Arshiagosh/Vision-Obstacle-Avoidance-Robot/docs/report/Goshtasbi_BSc_Thesis_fa.pdf

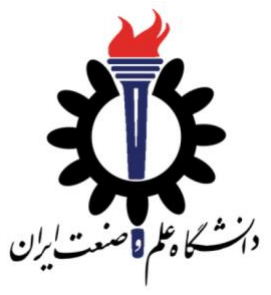
[picture p14: figure]

‌أ

دانشکده مهندسی برق

## طراح ی ، ساخت و کنترل ربات متحرک چرخدار در عبور از موانع با استفاده از دوربین و پردازش تصویر

پروژه پایانی کارشناسی در رشته مهندسی برق گرایش کنترل

ارشیا گشتاسبی حسن آبادی

استاد راهنما: دکتر محمد فرخی

تابستان 1403

ب‌

## تاییدیه هیئتداوران جلسه دفاع از پایاننامه /رساله

نام دانشکده: مهندسی برق

نام دانشجو: ارشیا گشتاسبی حسن آبادی

عنوان پایاننامه یا رساله: طراحی، ساخت و کنترل ربات متحرک چرخ دار در عبور از موانع با استفاده از دوربین و پردازش تصویر

تاریخ دفاع:

رشته: مهندسی برق

گرایش: کنترل

دانشگاه یا موسسه امضا | دانشگاهی | ردیف سمت نام و نام خانوادگی مرتبه
| | 1 استاد راهنما محمد فرخی استاد علم و صنعت ایران
| | 2 استاد مدعو داخلی جواد پشتان استاد علم و صنعت ایران

ت‌

### تایی دیه صحت و اصالت نتایج

باسمه تعالی

اینجانب ارشییا گشیتاسیبی حسین آبادی به شیماره دانشیجویی 98412391 دانشیجوی رشیته مهندسیی برق گرایش کنترل مقطع تحصییلی کارشیناسیی تایید می نمایم که کلیه ی نتایج این پایاننامه حاصیک کار اینجانب و بدون هرگونه دخک و تصرف است و موارد نسخهبرداری شده از آثار دیگران را با ذکر کامک مشخصات منبع ذکر کردهام. درصیورت اثبات خفف مندرجات فوق، به تشیخید دانشیگاه مطابا با بیوابم و مقررات حاکم ونانون حمایت از حقوق مؤلفان و مصیینفان و نانون ترجمه و تکریر کتب و نشییریات و آثار صییوتی، بییوابم و مقررات آموزشییی، پژوهشیی و انضیباطی ... با اینجانب رفتار خواهد شید و حا هرگونه اعتراد در خصیوح احقاق حقوق مکتسیب و تشییخید و تعیین تخلف و مجازات را از خویش سییلب مینمایم. در بییمن، مسییؤولیت هرگونه پاسییخگویی به اشییخاح اعم از حقیقی و حقونی و مراجع ذیصییف) واعم از اداری و نضییایی به عهدهی اینجانب خواهد بود و دانشگاه هیچگونه مسؤولیتی در این خصوح نخواهد داشت.

نام و نام خانوادگی: ارشیا گشتاسبی حسن آبادی

امضا و تاریخ:

ث‌

### مجوز بهرهبرداری از پایاننامه

بهره برداری از این پایاننامه در چهارچوب مقررات کتابخانه و با توجه به محدودیتی که توسیم اسیتاد راهنما به شر) زیر تعیین می شود، بفمانع است:

بهرهبرداری از این پایاننامه برای همگان بفمانع است. بهرهبرداری از این پایاننامه با اخذ مجوز از استاد راهنما، بفمانع است.
بهرهبرداری از این پایاننامه تا تاریخ | ممنوع است.

نام استاد یا اساتید راهنما: دکتر محمد فرخی

تاریخ:

امضا:

‌ج

## تقدیم به

## خانواده عزیزتر جانم،

برای عشق، حمایت، همراهی و دلگرمیهای بیپایان.

‌ح

### تشکر و تقدیر

با کمال افتخار و سیسا ، از اسیتاد گرانقدرم جناب آنای دکتر فرخی تشیکر میکنم. ایشیان نه تنها با دانش گسیترده و راهنماییهای ارزندهشیان در تمام مراحک این پروژه همراه من بودند، بلکه من را با نگاهی عمیاتر به علم و پژوهش آشیینا کردند. از ایشییان در های بسیییاری درباره تفکر نقادانه، حک مسییاوک، و پشییتکار در پژوهش آموختم که در طول این مسییییر و فراتر از آن، برای من ارزشیییمند خواهند بود. بیتردید، این پروژه بدون راهنماییها و حمایتهای بیونفهی ایشان به این مرحله نمیرسید.

‌خ

### چکیده

رباتهای متحرک یکی از پرکاربردترین سیستمهای کنترلی میباشند . در این پایان نامه، ربات دوچرخ دیفرانسیلی طراحی و ساخته شده که نادر است مسیر مناسب را طی کرده و از موانع پیشرو اجتناب کند. این ربات شامک دو چرخ مستقک متصک به موتور DC و یک چرخ هرزگرد است که با تغییر سرعت چرخ ها، سه درجه آزادی ومختصاتx، y و زاویه برای مانور را فراهم می سازد. هدف اصلی ربات، حرکت به سمت مقصد تعیین شده و اجتناب از موانع موجود در مسیر است. برای دستیابی به این هدف، دو الیه سیستم کنترلی به کار رفته است. در الیه پایین، انکودرها برای مونعیت یابی دنیا و کنترل سرعت ربات با استفاده از کنترل کننده PID بهکارگرفته شده اند. در الیه باالتر، حسگرهای فراصوت و دوربین ومتصک به یک سروو موتور به منظور تشخید موانع و هدایت هوشمند ربات برای جلوگیری از برخورد و انتخاب مسیر مناسب استفاده شده است. نتایج آزمایشهای عملی نشان داده است که ربات توانسته است با دنت باال مسیرهای مشخد شده را طی کرده و به طور همزمان از موانع اجتناب کند. این دستاورد نشان دهنده عملکرد مناسب سیستم های کنترلی و حسگرهای به کار رفته در این پروژه است.

کلیدواژه: ربات دوچرخ دیفرانسیلی، مسیریابی ربات، مونعیتیابی، اجتناب از موانع، انک ودر، کنترل کننده PID، پردازش تصویر، دوربین

‌د

فهرست

فصل :1 مقدمه 1 |
1-1 تاریخچه 2 |
2-1 مزایا و معایب 3 |
3-1 کاربردها 3 |
4-1 دستهبندی رباتهای متحرک چرخدار 4 |
5-1 مدلسازی 4 |
6-1 روش های اجتناب از مانع و مسیریابی 5 |
7-1 پردازش تصویر 6 |
8-1 شمای کلی از الیههای کنترلی 7 |
9-1 پیکربندی پایاننامه 8 |
1-2 مقدمه 10 |
2-2 بدنه 10 |
3-2 چرخها 11 |
4-2 موتورها 11 |
5-2 باتری 12 |
6-2 انکودر و مدار انکودر 13 |
7-2 کارانداز موتور 14 |
9-2 حسگرهای فراصوت 17 |
10-2 برد رزبریپای 18 |
11-2 ارتباط سریال 19 |
12-2 دوربین 20 |
13-2 سروو موتور 21 |

‌ذ

1-3 مقدمه 24 |
2-3 کنترل الیه پایین24 |
-2-3 1 کنترل موتور 25 |
-2-3 3 کنترل جهت نهایی 28 |
3-3 کنترل الیه باال29 |
-3-3 1 تونف در مقابک مانع و فرآیند اجتناب از مانع 29 |
-3-3 2 فاصلهسنجی با استفاده از دوربین 30 |
-3-3 3 بهترین زاویه خروج 32 |
1-4 مقدمه 35 |
2-4 طی کردن مسیر بدون مانع و رفتن به هدف 35 |
-2-4 1 حالت اول 35 |
-2-4 2 حالت دوم 38 |
-2-4 3 حالت سوم 41 |
3-4 طی کردن مسیر با مانع 44 |
-3-4 1 دور زدن مانعها 44 |
-3-4 2 حرکت از بین مانعها 48 |
4-4 جمعبندی و پیشنهادات 52 |
مراجع 53 |

‌ر

فهرست شکلها
شکک 1-1 مدل ریابیاتی ربات چرخدار دیفرانسیلی 4 |
شکک 2-1 شمای کلی از الیه های کنترلی 7 |
شکک 1-2 نمای جلو ربات ساختهشده10 |
شکک 2-2 نمای باال ربات ساختهشده11 |
شکک 3-2 موتور DC انکودردار12 |
13 | M25N-2R-14 | انکودر | 4-2 شکک
شکک 5-2 پایههای انکودر 14 |
شکک 6-2 ماژول N298L 14 |
شکک 7-2 نمای درونی کارانداز N298L15 |
شکک 9-2 حسگر فراصوت 04SR-HC17 |
شکک 10-2 برد رزبریپای 4 مدل B 19 |
20 | USB-STC-ISP مبدل 11-2 شکک
شکک 12-2 دوربین رزبریپای مدل 1.3v20 |
شکک 13-2 سروو موتور 90SG21 |
شکک 1-3 بلوک دیاگرام الیه پایین 24 |
شکک 2-3 نمایش انعکا دنیای سهبعدی برروی صفحع تصویر دوبعدی 31 |
شکک 3-4 نمودار تغییرات y برحسب زمان در مسیر بدون مانع و رفتن به هدف اول 37 |
شکک 4-4 نمودار سیگنالهای کنترلی اعمال شده به موتور چپ ربات در مسیر بدون مانع و رفتن به
هدف اول 37 |
شکک 5-4 نمودار سیگنالهای کنترلی اعمال شده به موتور راست ربات در مسیر بدون مانع و رفتن به
هدف اول 38 |
شکک 6-4 نمودار مسیر طی شده توسم ربات در مسیر بدون مانع و رفتن به هدف دوم 39 |

‌ز

شکک 7-4 نمودار تغییرات x برحسب زمان در مسیر بدون مانع و رفتن به هدف دوم 39 |
شکک 8-4 نمودار تغییرات y برحسب زمان در مسیر بدون مانع و رفتن به هدف دوم 40 |
شکک 9-4 نمودار سیگنالهای کنترلی اعمال شده به موتور چپ ربات در مسیر بدون مانع و رفتن به
هدف دوم 40 |
شکک 10-4 نمودار سیگنالهای کنترلی اعمال شده به موتور راست ربات در مسیر بدون مانع و رفتن به
هدف دوم 41 |
شکک 11-4 نمودار مسیر طی شده توسم ربات در مسیر بدون مانع و رفتن به هدف سوم 42 |
شکک 12-4 نمودار تغییرات x برحسب زمان در مسیر بدون مانع و رفتن به هدف سوم 42 |
شکک 13-4 نمودار تغییرات y برحسب زمان در مسیر بدون مانع و رفتن به هدف سوم 43 |
شکک 14-4 نمودار سیگنالهای کنترلی اعمال شده به موتور چپ ربات در مسیر بدون مانع و رفتن به
هدف سوم 43 |
شکک 15-4 نمودار سیگنالهای کنترلی اعمال شده به موتور راست ربات در مسیر بدون مانع و رفتن به
هدف سوم 44 |
شکک 16-4 نمودار مسیر طی شده توسم ربات در مسیر با مانع و دور زدن مانع 45 |
شکک 17-4 نمودار تغییرات x برحسب زمان در مسیر با مانع و دور زدن مانع 45 |
شکک 18-4 نمودار تغییرات y برحسب زمان در مسیر با مانع و دور زدن مانع | 46
شکک 19-4 نمودار سیگنالهای کنترلی اعمال شده به موتور چپ ربات در مسیر با مانع و دور زدن موانع
46 |
شکک 20-4 نمودار سیگنالهای کنترلی اعمال شده به موتور راست ربات در مسیر با مانع و دور زدن
موانع 47 |
شکک 21-4 حرکت ربات در مسیر با مانع 47 |
شکک 22-4 نمودار مسیر طی شده توسم ربات در مسیر با مانع و حرکت از بین موانع 48 |
شکک 23-4 نمودار تغییرات x برحسب زمان در مسیر با مانع و حرکت از بین موانع 48 |
شکک 24-4 نمودار تغییرات y برحسب زمان در مسیر با مانع و حرکت از بین موانع 49 |
شکک 25-4 نمودار سیگنالهای کنترلی اعمال شده به موتور چپ ربات در مسیر با مانع و حرکت از بین
موانع 49 |

س‌

شکک 26-4 نمودار سیگنالهای کنترلی اعمال شده به موتور راست ربات در مسیر با مانع و حرکت از بین
موانع 50 |
شکک 27-4 یک نمونه از تصاویر گرفتهشده از مانع توسم دوربین 51 |
شکک 28-4 تصویر گرفتهشده در شکک 27-4 پس از اعمال الگوریتم پردازش تصویر 51 |

ش‌

فهرست جدولها

جدول -2 1 پارامترهای موتور DC12 |
جدول -2 2 مشخصات Uno Arduino 17 |
جدول -2 3 مشخصات حسگر آلترسونیک 04SR-HC18 |
جدول -2 4 مشخصات برد رزبریپای 4 مدل B 19 |
جدول -2 5 مشخصات دوربین رزبریپای مدل 1.3v 21 |
جدول -2 6 مشخصات سروو موتور 90SG 22 |

## فصل :1 مقدمه

### 1-1 تاریخچه

رباتها، س یستمهای الکترومکانیکی پیشرفته ای هستند که از طریا برنامه ریزی کامسی وتری می توانند وظایف پیچیده و دنیا را به طور خودکار انجام دهند. این دستگاهها نابلیت جایگزینی نیروی انسانی در بسیاری از صنایع و کاربردها را دارند و به دلیک دنت، سرعت و نابلی ت اجرای مکرر وظایف بدون خطا، به ویژه در صنایع تولید ی مورد توجه نرار گرفته اند. یکی از اولین نمونه های کاربرد رباتیک در صنعت، بازوهای رباتیکی است که در انجام عملیات تکراری مانند جوشکاری، مونتاژ و بسته بند ی با دنت و سرعت بی نظیر به کار گرفته می شوند . اما این نوع ربات ها با وجود دنت و کارایی باال، در یک مح یم ثابت محدود هستند و امکان حرکت در فضا را ندارند، که این موبوع یکی از نقاط بعف آن ها محسوب م یشود.

در مقابک، ربات های متحرک دارای توانایی حرکت در محیم های پویا و نامشخد هستند که باعث
می شود انعطافپذ یری بیشتر ی نسبت به ربات های ثابت داشته باشند. این نوع ربات ها می توانند در فضاهای مختلف حرکت کرده، موانع را شناسایی کرده و با توجه به شرایم موجود، تصمیم گیر یهای هوشمندانه ای برای پیمایش مسیر اتخاذ کنند. چالشهای کلید ی در طراحی و استفاده از رباتهای متحرک شامک مسیریابی، مونعیت یابی دنیا و کنترل حرکات آن ها است. یک ربات متحرک باید به طور مستمر مونعیت خود را در فضا تعیین کند و با تحلیک اطفعات محی طی مانند موانع و مسیرها، بهترین و بهینه ترین راه را برای رس یدن به هدف انتخاب نماید .

رباتهای متحرک از دهه 1960 به این سو پیشرفت های نابک توجهی داشته اند. در سال ،1969 ربات Shakey توسم International SRI معرفی شد که اولی ن رباتی بود که نادر به برنامه ریزی، درک محیم و تصمیم گیری مستقک بود. این ربات از حسگرهایی مانند دورب ین و لی زر برا ی تشخید موانع و مسیریابی استفاده می کرد. در سال ،1977 دانشگاه توکیو ربات زیرآبی Pioneer را ساخت که می توانست به طور مستقک در اعماق انیانو ها حرکت کند. در دهه ،1990 ناسا با ارسال ربات Sojourner به مریخ، اولین کاوشگر رباتی ک مستقک را به کار گرفت که از حسگرها و دوربین ها برای شناسایی محیم استفاده می کرد. در سال ،2000 شرکت هوندا ربات انساننمای ASIMO را معرفی کرد که توانایی راه رفتن، دویدن و تعامک با انسان ها را داشت، گامی مهم در توسعه ربات های متحرک انسان نما. در دهه ،2010 ربات های پیشرفته تری مانند Quadrotor توسم دانشگاه زوریخ ساخته شد که به طور مستقک در فضاهای پیچ یده پرواز می کرد و حرکات مانورپذ یر انجام می داد. همچنین Spot از Dynamics Boston، با توانایی حرکت در محیم های ناهموار و پیچیده، نمایانگر نسک جد ید ی از رباتهای چهارپا بود.

تاریخچه ربات یک با سرعت زیادی در حال پیشرفت است و هر ساله شاهد معرف ی ربات های جد یدتر و هوشمندتری هستیم که نابلی تهای آن ها برای انجام وظای ف پیچیده تر و حرکت در محیم های پویا افزایش می یابد .

### 2-1 مزایا و معایب

باوجود مزایای رباتهای متحرک چرخدار، چالشهای نیز وجود دارند که در ادامه به مهمترین مزایا و معایب این ربات ها اشاره شده است.

مزایا:

- انعطافپذیری در فضاهای تنگ و کوچک
- سرعت باالی جابهجایی
- تعامک با محیم
- نابلیت استفاده در محیم های پرخطر و کاهش هزینهها
- سهولت ساخت و توسعه

معایب:

- محدودیت در حمک بار
- حساسیت به نوع سطح
- عملکرد نامطلوب در محیم هایی با شرایم سخت ومرف زمین ناهموار

### 3-1 کاربردها

ربیاتهیای متحرک چرخدار در حوزههیای مختلف کیاربرد دارنید. در انبیارداری و لجسیییتییک، این ربیاتهیا
برای جابهجایی کاالها بین نفسیهها در شرکتهایی مانند دیجیکاال و آمازون استفاده میشوند. در محیم های صیینعتی، این رباتها برای حمک نطعات به کار میروند. در هتکها و بیمارسییتانها، رباتها میتوانند دارو و مواد غیذایی را منتقیک کننید. همچنین در محیم هیای خطرنیاک مریک عملییاتهیای نجیات ییا منیاطا آلوده، بیه جای انسان به اکتشاف و جمعآوری اطفعات میپردازند .

### 4-1 دستهبندی رباتهای متحرک چرخدار

رباتهای متحرک چرخ دار به دو دسته کلی هولونومیک و غیرهولونومیک تقسیم می شوند. رباتهای هولونومیک دارای آزادی کامک در حرکت هستند و میتوانند به هر جهتی حرکت کنند. اما رباتهای غیرهولونومیک محدودیت های حرکتی دارند و معموالً فقم در جهتهای خاصی حرکت می کنند، مانند رباتهای دیفرانسیلی. در سیستم دیفرانسیلی، حرکت ربات به تفاوت سرعت چرخ های آن وابسته است، که این دسته از ربات ها برای حرکت در مسیرهای پیچیده و محیم های ناشناخته کاربرد دارند .

ربات متحرک مورد بررسی در این پایان نامه، ربات متحرک چرخ دار دیفرانسیلی غیرهولونومیکی با دو
چرخ کنترلپذیر و یک چرخ هرزگرد میباشد.

### 5-1 مدلسازی

از جهت شیناخت سییسیتم و در نتیجه طراحی کنترلکننده مناسیب، الزم اسیت که مدل ریابییاتی مبنی
بر معادالت سیینماتیکی مورد بررسیی نرار گیرند که معادالت و شیکک این ربات چرخدار به ترتیب در شیکک -1 1 و معادالت و1-1 ذکر شدهاند:

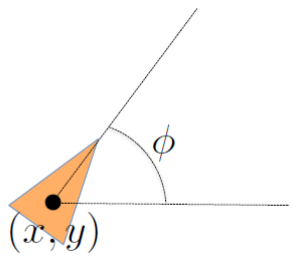
[picture p15: figure]

شکک :1-1 مدل ریابیاتی ربات چرخدار دیفرانسیلی

و1-1 ()ocv = ̇
ẏ = vsin(φ)
φ̇ = ω
الزم به ذکر اسیت که در این مدل، و به ترتیب سیرعت زاویهای خطی ربات میباشیند. با توجه به اینکه در الیه کنترلی پایین، که در آردوینو پیادهسیازی شیده اسیت، سیرعت دو موتور دو سیمت ربات کنترل

⁵

میشیییونید، تبیدییک این روابم بیه سیییرعیت خطی هر چرخ الزم اسیییت کیه این روابم در معیادالت و1-2 نیابیک مشاهدهاند:

و2-1 = ν

2v+ωL
2R
νL =

2v−ωL
2R
به ترتیب، سیرخت خطی چرخ | که در آنها ν و
های راسیت و چپ، و L و R به ترتیب عرد ربات و شیعاع
چرخهای ربات میباشند.

در مجموع، از رابطیه و1-1 برای کنترل مونعییت ربیات در جهیان خیارج و از رابطیه و2-1 برای کنترل سرعت چرخش هر چرخ استفاده میشود.

### 6-1 روش های اجتناب از مانع و مسیریابی

رباتهای متحرک چرخ دار به دلیک توانایی در حرکت در محیم های مختلف و مانورده ی در مسیرهای پیچیده، یک ی از مهم ترین موبوعات در علم رباتیک و مهندسی کنترل به شمار می روند . الگوریتم های مسیریابی و اجتناب از موانع برا ی هدای ت این ربات ها نقشی کل ید ی دارند. در ادامه چند ین الگوریتم مسیر یابی که به کنترل و هدایت رباتهای چرخ دار کمک می کنند، معرفی و بررس ی شده اند:

.1 الگوریتم تعقیب دیوار

1

این الگوریتم یک ی از ساده ترین و ابتدایی ترین روش های مسیریابی برای رباتهای متحرک است. ربات
با دنبالکردن دیوار یا موانع موجود، مسیر خود را ادامه م یدهد و با تنظی م حرکت خود بر اسا مونعیت موانع، از آن ها عبور می کند . ای ن روش بیشتر در محیم های محدود و ساختارهای مسدودشده استفاده می شود. با این وجود، این الگوریتم ی ک محدودیت دارد: ربات به تنهایی نادر به حرکت در فضای باز یا دور از موانع نیست [1].

.2 الگوریتم درخت جستجوی تصادفی سریع

2

الگوریتم RRT یکی از روش های پیشرفته برا ی مسیریابی در محیم های ناشناخته و پی چیده است. این الگوریتم با تولید تصادف ی نقاط در محیم و ایجاد یک درخت مسیر به ربات کمک م یکند تا سریعاً نقاط مختلف محیم را کشف کرده و بهینه ترین مسیر را بیابد . در محیم های بزرگ و ناشناخته، این روش به دلیک تولید سری ع مسیرها ی تصادف ی و سسس بهینه سازی آن ها، عملکرد بسیار خوب ی دارد [2].

1
Follow the wall
2 Rapidly Exploring Random Tree (RRT)

.3 الگوریتم ستاره

3

الگوریتم Star A یکی از محبوب ترین و شناخته شدهتری ن روش های مسیریابی است که بر مبنای جستجوی گراف استوار است. این الگوریتم با استفاده از روش های جستجوی هوشمندانه، کوتاه ترین مسیر را از مبدا به مقصد با در نظر گرفتن موانع موجود پیدا می کند . این الگوریتم به ویژه برا ی مسیریابی رباتهایی که به دنبال یافتن مسیرهای بهینه در محیم های مشخد هستند، بسیار مناسب است [3].

.4 الگوریتم مکان یابی و نقشه برداری همزمان بصری

4

یکی از روش های پیشرفته در رباتیک، استفاده از الگوریتم SLAM است که به ربات امکان می دهد
به طور همزمان محیم اطراف خود را نقشه برداری کرده و مونعیت خود را در آن مح یم تعیین کند. Visual SLAM از تصاویر دورب ین و لیزر برای به روزرسانی نقشه و تعیین مونعیت استفاده می کند . این الگوریتم به ربات اجازه میدهد تا بدون ن یاز به حسگرهای دیگر، تنها با استفاده از اطفعات بصر ی محیم، به طور دنیا مسیر خود را ط ی کند [4].

.5 الگوریتم میدان پتانسیک

5

در این روش، محیم اطراف ربات به عنوان یک میدان نیرو در نظر گرفته می شود؛ به طوری که موانع مانند نیروهای دافعه و هدف به عنوان نیروهای جاذبه عمک می کنند . ربات با هدایت خود در این میدان، به سمت هدف حرکت می کند و همزمان از برخورد با موانع جلوگیری می کند . این روش در عین سادگی، یکی از موثرتر ین روش ها برای اجتناب از موانع است، اما در شرای طی که موانع بسیار نزدیک به هم باشند ممکن است باعث گیر افتادن ربات شود [5].

این الگوریتم ها و روش های مسیریابی می توانند به عنوان ابزارهای مهمی در هدایت رباتهای متحرک
چرخ دار استفاده شوند. ترکی ب آن ها با پردازش تصویر به ویژه در محیم های ناشناخته و پی چیده می تواند به بهبود عملکرد و دنت مسیریاب ی کمک کند.

### 7-1 پردازش تصویر

پردازش تصویر یکی از روش های مؤثر در تشخید فاصله تا اجسام برای رباتهای متحرک است. دوربین مونو به عنوان یک حسگر بصری استفاده می شود که از طریا تبدیک سیگنال های نوری به داده های

3 A Star (A*)
4 Visual SLAM (Simultaneous Localization and Mapping)‌‌ 5 Potential Field

دیجیتال، امکان تحلیک عما را فراهم می کند. این داده ها با استفاده از الگوریتم های بینایی کامسیوتری و تکنیک های پردازش تصویر تجزیه و تحلیک می شوند و به ربات کمک می کنند تا فاصله تا موانع را تخمین زده و از آن ها جلوگیری کند. هدف این بخش، محاسبه دنیا فاصله با استفاده از اطفعات پیکسلی تصویر است. با این حال، در شرایطی که دنت بیشتری مورد نیاز باشد، از دوربین استریو نیز می توان بهره برد که به کمک تصاویر همزمان از دو زاویه، امکان محاسبه عما به شکک دنیا تری فراهم می شود. این روش ها نه تنها در جلوگیری از برخورد با موانع کاربرد دارند، بلکه به بهبود هدایت ربات در محیم های پیچیده نیز کمک می کنند . هر تصویر به عنوان سیگنالی شامک مقادیر پیکسلی است که پس از نمونه برداری به سیگنال دیجیتال تبدیک می شود . بینایی کامسیوتری راهی برای شبیه سازی توانایی یادگیری و کسب اطفعات از ورودی های بصری است که رایجترین آن، استفاده از دوربین و پردازش تصاویر برای تحلیک و تصمیم گیری در مورد محیم است.

### 8-1 شمای کلی از الیههای کنترلی

با توجه به طراحی ربات بهصورت الیه الیه و نابلیت جایگزینی آنها، یک شمای اولیه و کلی از اجزای ربات و ارتباط آنها باهم در شکک2-1 اراوه شدهاست.

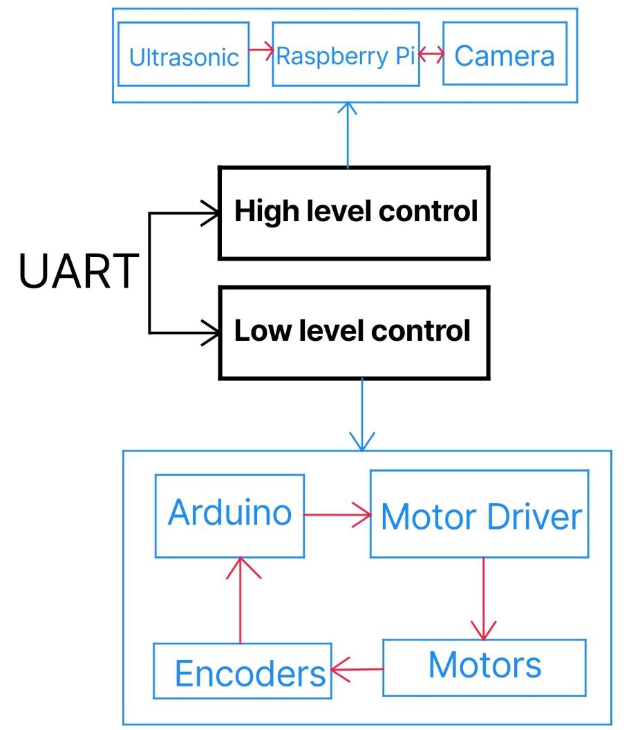
[picture p16: figure]

شکک :2-1 شمای کلی از الیههای کنترلی

### 9-1 پیکربندی پایاننامه

در ادامه، این پایاننامه در نالب فصکهای زیر دنبال می شود: فصک دوم به معرفی و توبیح ساختار مکانیکی و الکترونیکی ربات میپردازد. در این فصک به بررسی نطعات، میکروکنترل کنندهها و بردهای استفاده شده پرداخته میشود. سسس در فصک سوم الگوریتمهای کنترل در دو الیه پایین و باال و الگوریتمهای پردازش -تصویر اراوه میگردند. در فصک چهارم نیز نتایج حاصک از آزمایشهای عملی صورت گرفته بر ربات در حالتهای مختلف گزارش میشوند و در پایان این فصک، جمعبندی و پیشنهادات اراوه خواهد گردید.

## فصل :2 ساختار مکانیکی و الکترونیکی ربات

### 1-2 مقدمه

ربات طراحیشده از نوع رباتهای متحرک چرخ دار است و دارای بدنهای مستطیک شکک و دو چرخ متصک به دو موتور DC انکودردار میباشد. چرخها دارای یک درجه آزادی بوده و ربات از نوع غیرهولونومیک است. در ارتباط با ساختار کلی ربات، با توجه به طراحی الیهای، از دو برد آردوینو و رزبریپای به صورت همزمان استفاده میشود. در الیه پایین کنترلی، انکودرها، کارانداز موتورها، مدار تغذیه و برد آردوینو نرار دارند. در الیه باال نیز، برد رزبریپای، دوربین، حسگر فراصوت و سروو موتور برای چرخاندن دوربین نرار داده شدهاند.

در این فصک به بررسی ساختمان و ادوات مکانیکی و همچنین مدارهای الکترونیکی گوناگون به کاررفته
در این ربات پرداخته میشود.

### 2-2 بدنه

بدنهی ربات از دو شاسی مستطیک به طول 16 سانتیمتر و عرد 14سانتیمتر تشکیک شده است که بهوسیله چهار پایه به هم متصک شدهاند. یک بردبُرددر طبقه پایین نرار داده شده است و آردوینو و اتصاالت آن در این طبقه انجام شده است. در طبقه باال، برد رزبری پای، کارانداز موتورها، باتری، سروو موتور و دوربین متصک به آن و حسگرهای فراصوت نرار داده شده است. موتورها به کناره شاسی پایینی متصک میشوند. جنس شاسیها از پلکسی به بخامت 3 میلیمتر میباشد که باعث سبکی ربات میشوند. در شککهای -2 1 و -2 2 ربات ساخته شده مشاهده میشود.

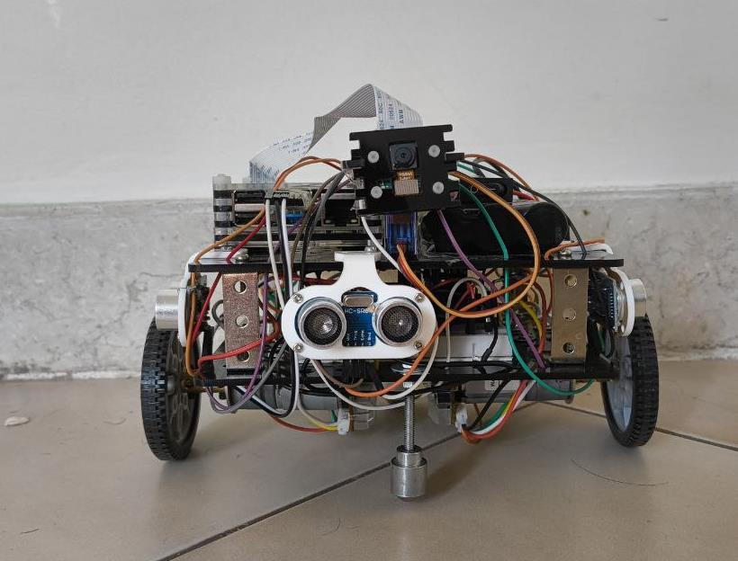
[picture p17: figure]

شکک :1-2 نمای جلو ربات ساختهشده

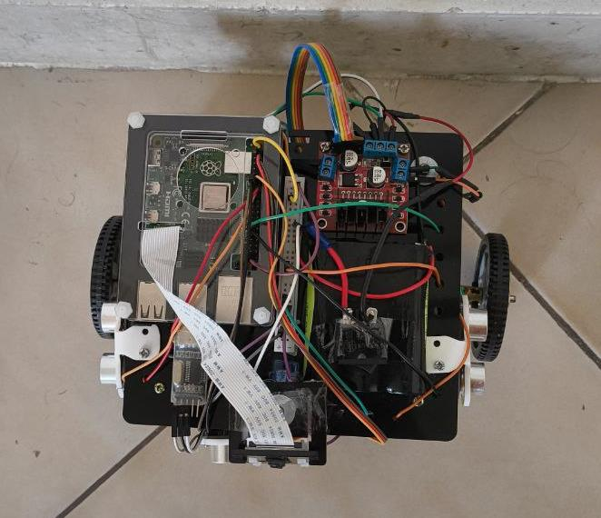
[picture p18: figure]

شکک :2-2 نمای باال ربات ساختهشده

### 3-2 چرخها

ربات دارای دو چرخ پفستیکی به شعاع 3 سانتیمتر میباشد که مرکز چرخها به شفت موتورها متصک شدهاند و موتور از طریا براکتها به بدنه ربات اتصال دارد. چرخها باید بهگونهای باشند که هنگام حرکت دچار لغزش نشوند و تمام محورهای فرمان چرخ عمود بر زمین باشند. چرخهای این ربات موازی هم نرار گرفتهاند که در این حالت به آنها Dicycle گفته میشود. ربات دارای یک چرخ هرزگرد نیز میباشد.

### 4-2 موتورها

در ساخت این ربات از دو موتور DC انکودردار استفاده شدهاست که این موتورها به شفت چرخها متصک میشوند. موتور بهکار بردهشده دارای 1.5 ولت باند مرده میباشد. در ولتاژهای بسیار پایین، گشتاور کمتر از حدی است که بتواند بر نیروهای بازدارنده غلبه کرده و موتور را به حرکت درآورد. به ناحیهای که ولتاژ اعمالی تاثیری بر حرکت موتور ندارد باند مرده گفته میشود. با توجه به وجود این مسئله، برای کنترل موتورها، این مقدار باید همواره در نظر گرفته شود و به سیگنال کنترلی اعمال گردد. از سویی الزم به ذکر است که برای کنترل این موتورها به کارانداز نیاز است که در ادامه توبیح داده شدهاست.

پارامترهای موتورهای استفاده شده در جدول 1-2 نابک مشاهده است. همچنین در شکک 3-2 موتور موردنظر مشاهده میشود. موتور استفاده شده از برند الندا الکترونیک میباشد.

جدول :1-2 پارامترهای موتور DC
| ولتاژ کاری V 12
| سرعت بیباری rpm 430
| سرعت خروجی rpm 370
3 kg.cm | گشتاور
| جریان نامی A 1.8
| جریان راهاندازی mA 400
| نسبت گیربکس 1:21

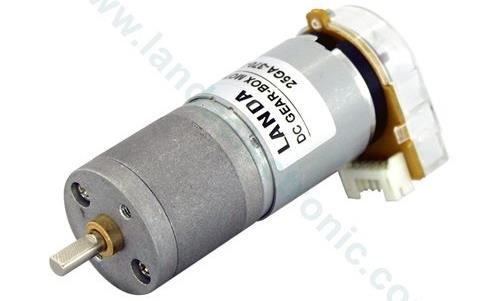
[picture p19: figure]

شکک :3-2 موتور DC انکودردار

### 5-2 باتری

باتری استفاده شده برای ربات از نوع باتری لیتیوم یونی 12 ولت و 2.5 آمسرساعت میباشد. این باتریها
نابک شارژ هستند. برای ساخت این باتری، از سری کردن سه باتری تکی استفاده شده است. باتوجه به ساختار این نوع باتریها، آنها نابک استفاده درحوزههای گوناگون بدون احتیاج به تعمیر و اصف) میباشند. از این باتری برای تغذیه کارانداز موتور استفاده میشود.

یکی از عوامک اصلی که باعث خرابی این نوع باتری ها میشود، دمای باالی محیم است؛ زیرا حرارت زیاد می تواند عمر مفید باتری را کاهش دهد. همچنین، حضور گرد و غبار فراوان می تواند عملکرد باتری را مختک کرده و به آسیب های جدی منجر شود.

### 6-2 انکودر و مدار انکودر

از آن جهت که از حسگرهای جانبی مانند IMU و GPS برای مونعیتیابی این ربات استفاده نمیشود، استفاده از انکودر با دنت باال برای محاسبه میزان چرخش هر چرخ الزامی است. انکودرهای متصک به چرخها از دنت باالیی برخوردار میباشند و مناسب اند.

این انکودرها به واسطه دیسکهای شیاربندیشده کار میکنند. اشعه نوری که توسم یک LED تولید
می شود، از شیارهای روی دیسک عبور کرده و توسم حسگری مانند دیود یا ترانزیستور نوری آشکار می شود. با چرخش دیسک، اشعه نوری به طور متناوب نطع و وصک شده و خروجی پالس تولید میشود. تعداد پالسهای تولیدی متناسب با زاویه چرخش دیسک است و دنت انکودر به تعداد شیارهای دیسک بستگی دارد؛ هرچه شیارهای بیشتری روی دیسک باشد، دنت تشخید مونعیت و زاویه چرخش بیشتر خواهد بود.

هر انکودر دارای دو سیگنال خروجی است، A و B، که با استفاده از توالی زمانی پالسهای آن ها می توان
جهت چرخش موتور را تشخید داد. زمانی که دیسک انکودر شروع به چرخش می کند، پالسهایی از هر دو انکودر تولید می شود. بسته به اینکه کدام انکودر ابتدا پالس را ارسال کند، می توان تشخید داد که جهت چرخش ساعتگرد یا پادساعتگرد است.

انکودر استفادهشده در این پروژه، از برند MITSUMI مدل -14R-2N25M میباشد. این انکودر در
هر گردش موتور 2625 پالس تولید میکند. برای شمارش پالسها از لبه باالرونده استفاده شدهاست. در شکک 4-2 این انکودر و در شکک 5-2 پایههای این انکودر ذکر شده است:

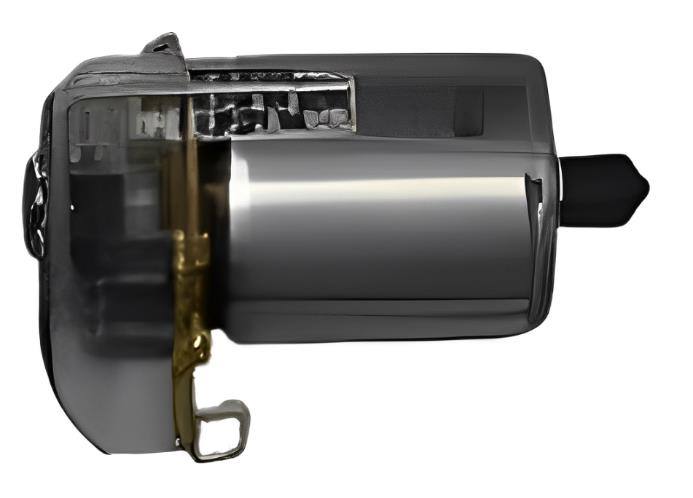
[picture p20: figure]

M25N-2R-14 | انکودر | :4-2 شکک

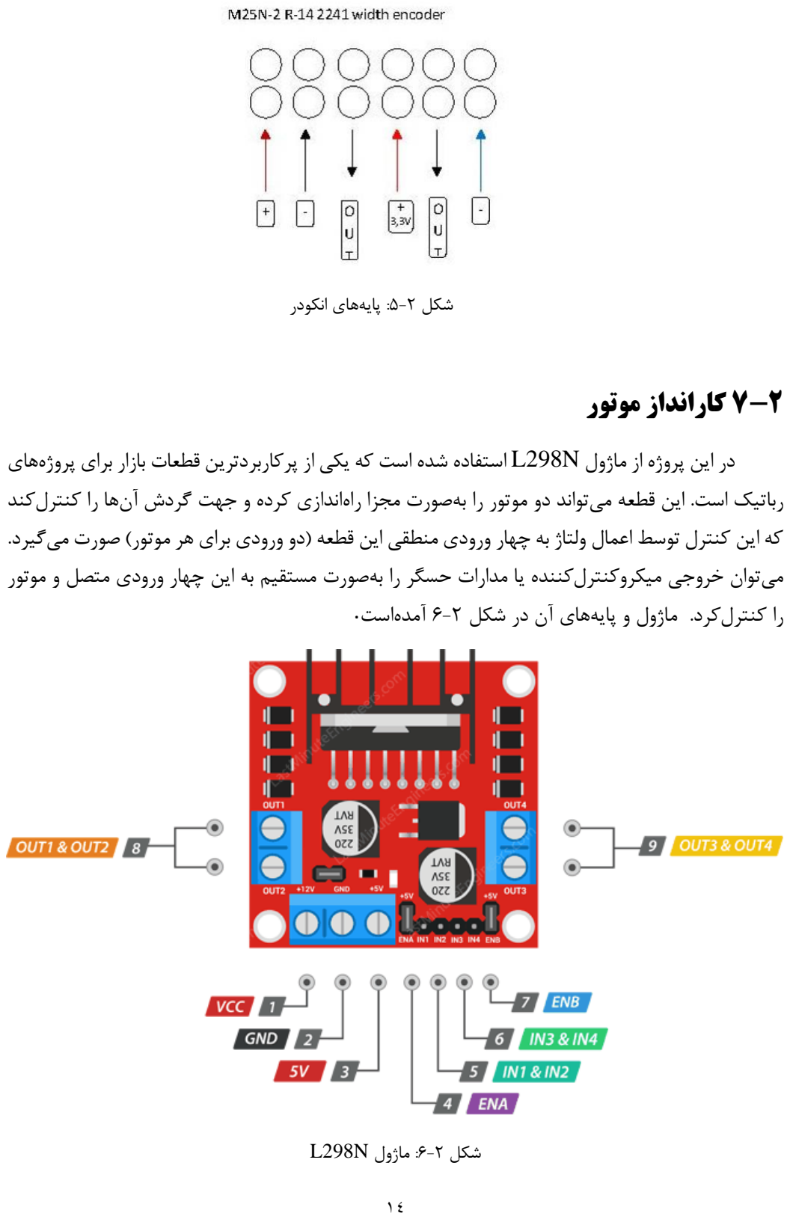
[picture p21: page 27]

شکک :5-2 پایههای انکودر

### 7-2 کار انداز موتور

در این پروژه از ماژول N298L استفاده شده است که یکی از پرکاربردترین نطعات بازار برای پروژههای رباتیک است. این نطعه میتواند دو موتور را بهصورت مجزا راهاندازی کرده و جهت گردش آنها را کنترل کند که این کنترل توسم اعمال ولتاژ به چهار ورودی منطقی این نطعه ودو ورودی برای هر موتور صورت می گیرد. میتوان خروجی میکروکنترل کننده یا مدارات حسگر را به صورت مستقیم به این چهار ورودی متصک و موتور را کنترل کرد. ماژول و پایههای آن در شکک 6-2 آمدهاست.

شکک :6-2 ماژول N298L

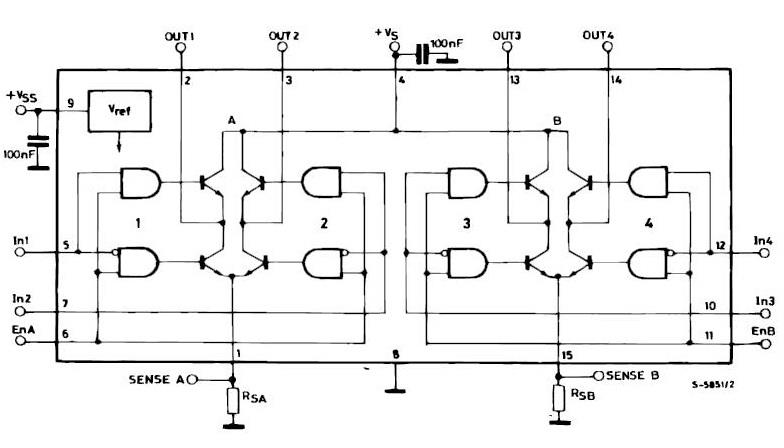
[picture p22: figure]

1⁵

کارانداز N298L دارای دو پایه خروجی A و B است . خروجی توان دارای پیکربندی پک H مانند است
و خروجی آن میتواند بارهای القایی ساده یا تفابلی ودیفرانسیلی را کنترل کند . جریان عبوری از میان بار از میان پایه تحریک خروجی عبور میکند . مقاومت خارجی اجازه تغییر شدت این جریان را مشخد می کند .

هر پک H کارانداز شامک چهار گیت منطقی است که پایه های ورودی 1IN، 2IN، 3IN و 4IN برای کنترل مستقیم ولتاژ و حرکت موتورها استفاده می شوند. در این پروژه، پایه های1IN و 2IN برای کنترل جهت و میزان حرکت موتور چپ و پایه های3IN و 4IN برای کنترل موتور دوم به کار میروند. با استفاده از سیگنالهای PWM در این پایهها، می توان جهت چرخش و سرعت موتورها را به صورت دنیا تنظیم کرد.

پایههای ENA و ENB برای فعال یا غیرفعال کردن موتورها استفاده می شوند؛ ونتی این پایهها فعال باشند، موتور می تواند به حرکت درآید و هنگامی که غیرفعال شوند، موتور متونف میشود. برخفف روش سنتی که پایه های ENA و ENB برای تنظیم سرعت با PWM به کار میروند، در این طراحی این پایهها نقش فعال سازی و غیرفعالسازی دارند. گیت های منطقی به کار رفته در این کارانداز از نوع TTL هستند که در طراحی مدارات دیجیتال با ولتاژ پایین عملکرد خوبی دارند . شکک -2 7 نمای درونی کارانداز را که شامک پکها و گیتهای منطقی میباشد .

الزم به ذکر است که یک پایه با خروجی 5 ولت بر روی این ماژول وجود دارد که از آن برای تغذیه برد آردوینو استفاده میشود.

شکک :7-2 نمای درونی کارانداز 298L

### 8-2 آردوینو

آردوینو یک پلتفرم متن باز متشکک از سخت افزار و نرم افزار است که برای توسعه سریع و ساده پروژه های الکترونیکی تعاملی طراحی شده است. بخش سخت افزاری این پلتفرم شامک یک برد است که میکروکنترلری را برای کنترل و اجرای برنامه ها در خود دارد و عفوه بر آن، پایههای ورودی و خروجی عمومی (GPIO (بر روی این برد وجود دارند . شرکت آردوینو با نرم افزاری به نام IDE Arduino اراوه میدهد که برنامه نویسان با استفاده از آن می توانند به زبان ++C کدنویسی کرده و برنامه های خود را روی بردهای آردوینو بارگذاری کنند. عفوه بر آن، این برد کنترلی دارای کتابخانه های مخصوح خودش است که برنامه نویسی برای کنترل ربات را از زبان ++C راحت تر می کند. همچنین، این نرم افزار دستورات پایتون را نیز میپذیرد.

این پلتفرم به گونه ای طراحی شده که کاربران با تجربه های مختلف، از مبتدی تا حرفه ای، بتوانند
به راحتی وسایلی بسازند که با محیم فیزیکی تعامک دارند، مانند ربات ها، سیستمهای هوشمند و پروژه های اینترنت اشیاء.

در ربات متحرک سییاختهشییده، از آردوینو Uno بهعنوان هسییته مرکزی ربات در الیه پایین کنترلی اسیتفاده شیده اسیت. در جدول 2-2 برخی مشیخصیات این برد مشیاهده میشیود. این برد کنترلی وظیفه دریافت داده از حسگرها، پردازش آنها و محاسبه و اعمال سیگنال کنترلی مناسب را بر اسا الگوریتم کنترلی دارد. در این برد از میکروکنترلر P328ATmega استفاده شده است.

آردوینو Uno دارای 14 پیاییه ورودی و خروجی دیجیتیال اسیییت کیه 6 عیدد از آنهیا نیابلییت تولیید سییگنال PWM را دارند. عفوه بر آن، این برد دارای 6 پایه ورودی آنالوگ اسیت. همچنین، سیرعت پردازش این برد به واسیطه پالس سیاعت 16 مگاهرتز برای بسییاری از کاربردهای رباتیکی کافی است. این برد همچنین امکان ارتباط سیریال با کامسیوتر را از طریا پورت USB فراهم میکند. در شیکک 8-2 پایههای برد آردوینو Unoمشاهده میشود.

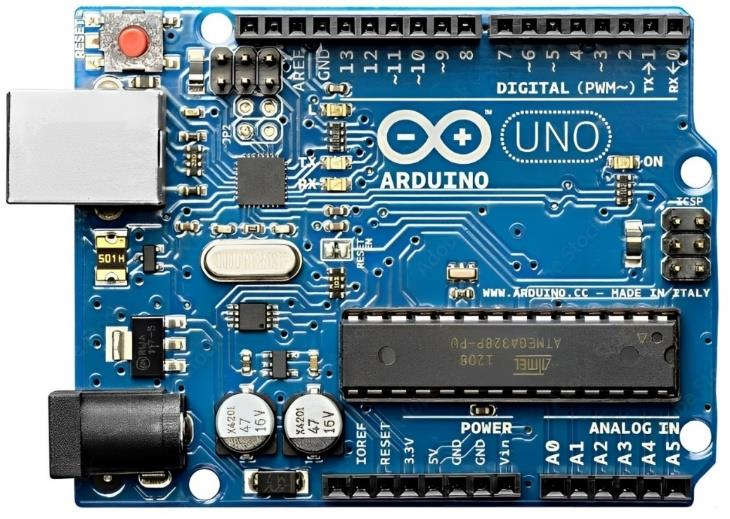
[picture p23: figure]

شکک :8-2 برد آردوینو Uno

جدول :2-2 مشخصات Uno Arduino
| نوع میکروکنترل کننده P328ATmega
| ولتاژ کاری V 5
| پایههای ورودی و خروجی دیجیتال pins 14
| پایههای ورودی آنالوگ pins 6
| پایههای خروجی آنالوگ ندارد
| جریان DC حروجی در پایه ها mA 40
| حافظه KB 32
2 KB | SRAM
| سرعت پالس ساعت MHz 16
mm .4 | ابعاد 53*68.6

الزم به ذکر است که الیه کنترلی پایین، در این برد پیادهسازی میشود و رفتار رفتن به هدف با ارسال دستور واز طریا ارتباط سریال به این برد انجام میپذیرد.

### 9-2 حسگرهای فراصوت

نحوه کار این حسگر به اینصورت است که ابتدا فرستنده حسگر، یک موج از نوع امواج صوتی با فرکانس باال ارسال میکند. این موج هنگام برخورد با مانع بازتاب می شود و توسم گیرنده حسگر دریافت میشود. مدت زمان بازگشت موج صوتی برای اندازه گیری فاصله استفاده میشود. حسگر فراصوت 04SR-HC از رایجترین حسگرهای فراصوت است که در این پروژه نیز از آن استفاده شدهاست و بازه کاری آن 2 تا 400 سانتیمتر است. در شکک 9-2 نمایی از این حسگر و نحوه عملکرد آن نشان داده شدهاست. از پایههای Trig و Echo برای فرمان فرستادن و دریافت کردن سیگنال بازگشتی موج استفاده میشود. در جدول 3-2 مشخصات حسگر 04SR-HC آورده شدهاست.

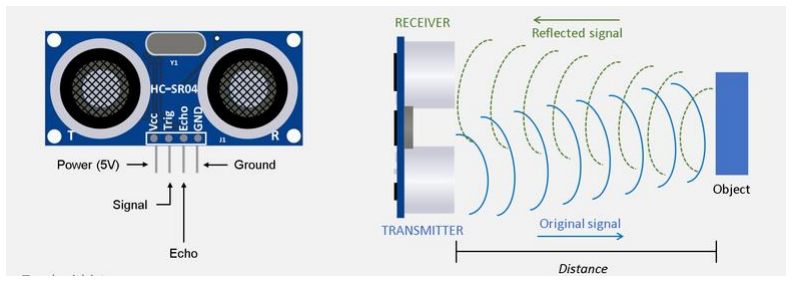
[picture p24: figure]

شکک :9-2 حسگر فراصوت 04SR-HC

جدول :3-2 مشخصات حسگر فراصوت 04SR-HC
| ولتاژ کاری DC V5
| جریان کاری mA15
| بازه کاری cm 200 – 4
| رزولوشن cm 0.3
s | زاویه نابک اندازه گیری degree 15
| فرکانس کاری KHz 40
| ابعاد mm 15*20*45

### 10-2 برد رزبریپای

در این ربات، از برد رزبریپای 4 مدلB، برای انجام محاسیبات و پردازش تصیاویر گرفتهشیده توسیم دوربین اسیتفاده شیده اسیت. رزبریپای یک رایانه کوچک و ندرتمند اسیت که تمامی اجزای آن بر روی یک برد نرار داده شیدهاند. این برد نادر اسیت سییسیتمعامک رزبین (Raspbian (یا دیگر نسیخههای لینوکس مانند Ubuntu را اجرا کند که این سیییسییتمعامکها بر پایه لینوکس Debian سییاخته شییدهاند. رزبریپای از نرمافزارهای اسییتاندارد لینوکس از جمله مرورگر وب، سییرویسهای ایمیک، ابزارهای سیییسییتمی، و ابزارهای برنامهنویسی همچون پایتون و C پشتیبانی میکند .

در این ربات، سیه حسیگر فراصیوت برای تشیخید فاصیله و موانع، به GPIOهای رزبریپای متصیک شیدهاند. همچنین، یک دوربین برای پردازش تصیویر به رزبریپای متصیک اسیت که وظیفه ارسیال تصیاویر برای تحلییک و پردازش را دارد. عفوه بر این، ییک سیییروو موتور نیز برای حرکیت و کنترل زاوییه دیید دوربین بیه رزبریپای وصک شده است تا دوربین بتواند در جهات مختلف چرخش داشته باشد .

رزبریپای 4 مدل B دارای 40 پایه GPIO برای ارتباط با سایر سختافزارها و حسگرها است. این برد
با اسیتفاده از یک کابک C-USB تغذیه میشیود و دارای پورتهای متعددی از جمله دو پورت HDMI برای خروجی تصییویر، چهار پورت USB) دو پورت 3.0 USB و دو پورت 2.0 USB (و یک پورتmicroSD برای بارگذاری سییسیتمعامک و ذخیرهسیازی دادهها اسیت. رزبریپای به دلیک امکانات و توانمندیهای خود، یکی از انتخابهای محبوب در پروژههای رباتیک، اتوماسیون و اینترنت اشیا به شمار میرود. در شکک ،10-2 برد رزبریپای 4 مدل B مشاهده میشود و در جدول 4-2 مشخصات این برد آورده شده است.

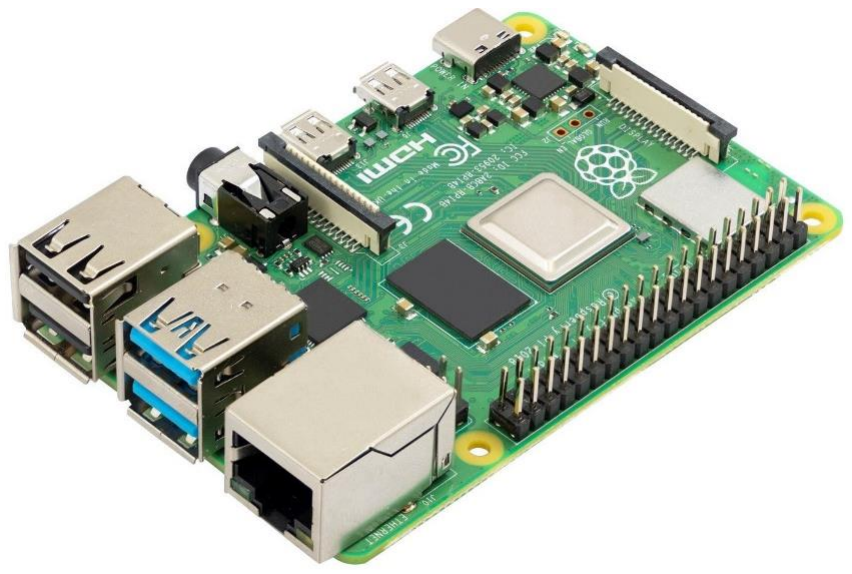
[picture p25: figure]

شکک :10-2 برد رزبریپای 4 مدل B

جدول :4-2 مشخصات رزبریپای 4 مدل B

A72 CPU | پردازنده quad-core ARM Cortex-
8GB LPDDR4 SDRAM | حافظه
| پایههای ورودی و خروجی pins 40
| دمای کاری degrees 50 – 0
| ولتاژ کاری DC V5
| جریان A 3.0
| سرعت پردازنده GHz 1.5

### 11-2 ارتباط سریال

UART یک پروتکک ارتباط سریال آسنکرون است که داده ها را به صورت بیت به بیت و متوالی ارسال
می کند. این پروتکک نیازی به هم زمانسازی ساعتی ندارد و از دو خم اصلی TX وارسال و RX ودریافت برای انتقال داده استفاده می کند. در این پروتکک، نرخ ارسال داده ها (rate baud (باید در هر دو دستگاه یکسان باشد تا ارتباط به درستی برنرار شود. این پروتکک یکی از ساده ترین و پرکاربردترین روش های ارتباط سریال بین دستگاه ها است، به ویژه در پروژه های رباتیک و اینترنت اشیا.

در این پروژه، برای ارتباط سریال بین برد آردوینو و رزبری پای از مبدلISP-STC-USB استفاده شده
است. این مبدل پورت USB رزبریپای را به خروجی های TTL تبدیک کرده و سسس به پایه های آردوینو متصک می شود. دلیک استفاده از این مبدل، تفاوت ولتاژ پایه های GPIO است؛ چراکه GPIOهای رزبری پای

3.3 ولت و آردوینو 5 ولت هستند، و اتصال مستقیم می تواند به رزبری پای آسیب بزند . در شکک -2 11 مبد ل ISP-STC-USB نابک مشاهده است:

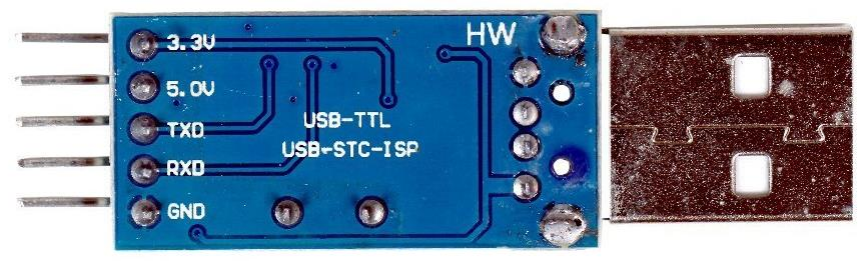
[picture p26: figure]

USB-STC-ISP مبدل :11-2 شکک

### 12-2 دوربین

برای تشیخید فاصیله با اسیتفاده از پردازش تصیویر، نیاز به دوربین اسیت. از دوربین 5 مگاپیکسیلی
1.3v رزبریپای اسیتفاده شیده اسیت. این دوربین از طریا یک کابک فلت به اسیفت CSI رزبریپای متصیک میشیود. تمامی مدلهای رزبریپای دارای این اسیفت هسیتند که امکان اتصیال و کنترل مسیتقیم دوربین را فراهم میکنید. بیا اسیییتفیاده از رزبریپیای، میتوان بیه دوربین فرمیان داد و تنظیمیات مختلف آن را از طریا سیستمعامک Raspbian مدیریت کرد.

راهانیدازی دوربین بیه دو روش امکیانپیذیر اسیییت: اسیییتفیاده از خم فرمیان (line command (در سییسیتمعامک و یا برنامهنویسیی از طریا پایتون. این دوربین برای کاربردهای رباتیکی و تشیخید فاصیله، بهویژه زمانی که نیاز به پردازش تصیویر اسیت، انتخاب مناسیبی اسیت. در شیکک ،12-2 دوربین رزبریپای و در جدول ،5-2 مشخصات آن آورده شده است.

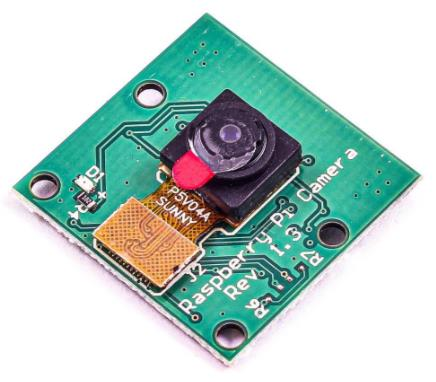
[picture p27: figure]

شکک :12-2 دوربین رزبریپای مدل 1.3v

جدول :5-2 مشخصات دوربین رزبریپای مدل 1.3v

| اندازه mm 9×24×25
| رزولوشن Megapixels 5
| نوع حسگر 5647OV OmniVision
| فاصله کانونی mm 3.6
36 dB | S/N نسبت

### 13-2 سروو موتور

سروو موتور یک نوع موتور الکتریکی است که برای کنترل دنیا مونعیت زاویه ای طراحی شده است.
این موتورها به طور گسترده ای در پروژه های رباتیک و سیستمهای کنترل مونعیت استفاده می شوند. سروو موتور با استفاده از سیگنالهای PWM کنترل می شود تا در زاویه مورد نظر نرار گیرد. این موتورها معموالً دارای یک موتور DC کوچک و جعبه دنده هستند که به آن ها امکان می دهد در محدوده خاصی از زاویه، حرکت کنند و مونعیت خود را ثابت نگه دارند .

در این پروژه، سروو موتور 90SG بهعنوان مکانیزم چرخش دوربین استفاده شده است. دوربین رزبری پای از طریا یک براکت به این سروو موتور متصک شده است. با استفاده از سیگنالهای PWM که از پایههای GPIO رزبریپای تولید می شود، سروو موتور به طور دنیا به زاویه مطلوب حرکت کرده و دوربین را در مونعیت مورد نظر نرار میدهد. این تنظیمات به دوربین این امکان را می دهد که با دنت باال و به طور خودکار زاویه دید خود را تغییر دهد و تصاویر مناسبی از محیم اطراف اراوه دهد . در شکک ،13-2 موتور 90SG و در جدول -2 6 مشخصات آن ذکر شدهاست:

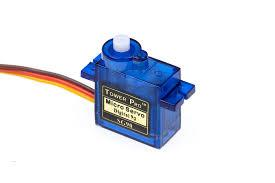
[picture p28: figure]

شکک :13-2 سروو موتور 90SG

جدول :6-2 مشخصات سروو موتور 90SG

| مدل 90SG
| ولتاژ عملیاتی V6 – V4.8
| چرخش زاویهای degrees 180 – 0
1.8 KG.cm | گشتاور
| نوع سیگنال کنترل PWM
| ابعاد mm 12.2*22.8*28.5

## فصل :3 کنترل ربات

### 1-3 مقدمه

در فصییک ،3 به بررسییی جزویات و الگوریتمهای مختلف بهکاررفته برای کنترل ربات پرداخته خواهد شیید. کنترل ربات در این پروژه به دو الیه کنترلی تقسیییم میشییود. در الیه پایینی، که بر روی برد آردوینو پیاده سیازی شیده اسیت، از فیدبک انکودر برای اندازهگیری فاصیلهها و تعیین مونعیت ربات اسیتفاده میشیود. در این الیه، رفتار رفتن به هدف(behavior goal to Go (بهوسیییله کنترلکنندهها پیادهسییازی شییده و مونعیت ربات بهطور دنیا کنترل میشیود. در الیه باال، که بر پایه رزبریپای نرار دارد، سیه حسیگر فراصیوت وبرای چپ، راسیت و باال بهطور مداوم فاصیلهها را اندازهگیری میکنند. زمانی که یکی از این حسیگرها مانعی را شیناسیایی کند، ربات به حالت اجتناب از مانع (avoidance Obstacle (وارد میشیود. در این حالت، ربات 7 زاویه مختلف را بررسیی میکند: 5 زاویه توسیم دوربین که با اسیتفاده از سیروو موتور تنظیم میشیود و 2 زاویه دیگر توسیم حسیگرهای فراصیوت چپ و راسیت بهدسیت میآید. بر اسیا این دادهها، ربات تصیمیم میگیرد که به چه زاویهای بچرخد و سسس به سمت هدف حرکت کند.

### 2-3 کنترل الیه پایین

هدف اصلی این الیه، پیادهسازی رفتار رفتن به هدف است و ورودی مقصد را، از الیه باالتر دریافت میکند. برای پیاده سازی این رفتار، در مرحله اول نیاز به کنترل سرعت هر موتور به صورت جداگانه با استفاده از کنترلکننده PID میباشد . مرحله بعدی، کنترل مونعیت با استفاده از انتگرالگیری از سرعت هر موتور و استفاده از معادالت سینماتیک برای مونعیتیابی ربات میباشد . در انتها برای اینکه ربات در جهت مطلوب نرار گیرد، باید با استفاده از کنترلکننده PID در زاویه نهایی نرار گیرد. بلوک دیاگرام کلی این الیه در شکک 3-1 رسم شده است و تمام بخشها به صورت کامک توبیح داده خواهد شد.

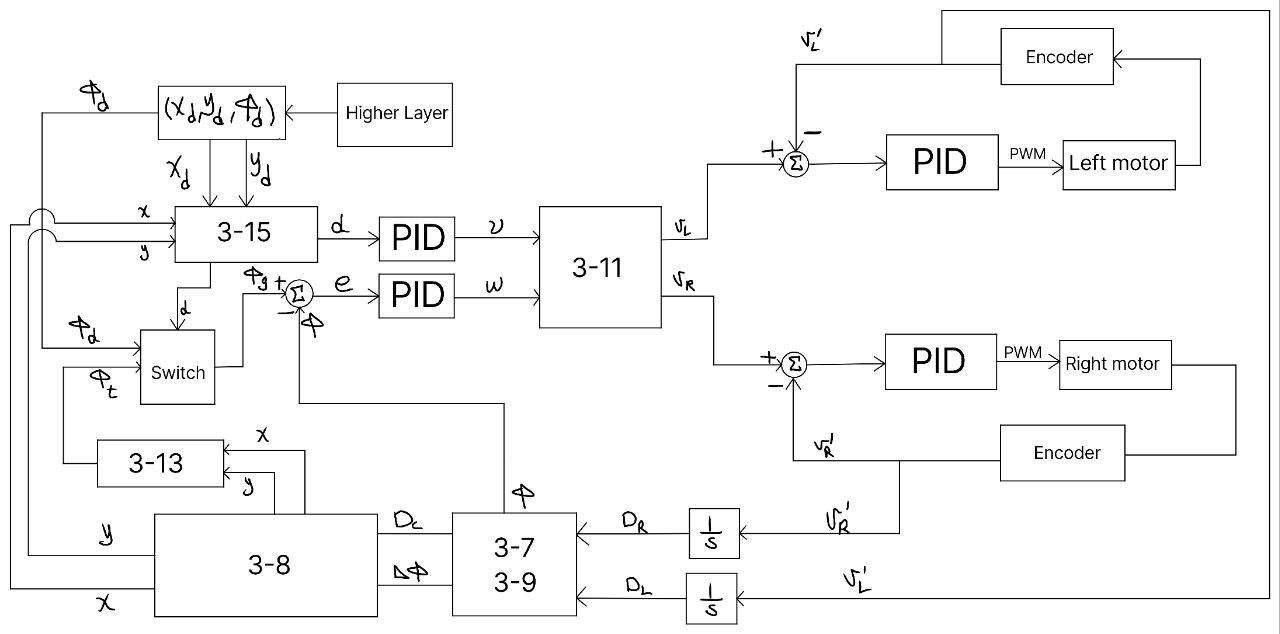
[picture p29: figure]

شکک :1-3 بلوک دیاگرام الیه پایین

2⁵

### 1-2-3 کنترل موتور

برای مدلسیازی و کنترل موتور DC در ربات، ابتدا باید ورودیها و خروجیهای سییسیتم مورد بررسیی نرار گیرند. ورودی موتور یک ولتاژ DC بین 0 تا 12 ولت اسیت که توسیم پالسهای PWM تولید میشیود. از آنجا که ورودی موتور در نرمافزار با تغییر عرد پالس PWM مشیخد میشیود، برای مدلسیازی دنیاتر موتور، ورودی باید به عرد پالس تبدیک شود.

برای بررسیی عملکرد موتور، ورودی پله انتخاب شیده اسیت. این ورودی شیامک توابع مختلف فرکانسیی
اسیت و به دلیک اینکه شیامک بسییاری از فرکانسها میباشید، به خوبی نادر اسیت لقی موتور در حرکت رفت و برگشت را نشان دهد. ورودی پله به صورت مربت و منفی اعمال میشود تا این لقیها بهتر بررسی شوند .

خروجی سییسیتم، که سیرعت چرخش موتور اسیت، از طریا شیمارش تعداد پالسهای انکودر بهدسیت میآید. برای این منظور، تعداد پالسهای انکودر به ازای یک دور کامک چرخش شییمرده میشییود. معادالت و1-3 برای محاسبه سرعت خروجی استفاده میشوند :

Round =

tick
N

و1-3

RPM =

Round
△t
در این معادالت:
- N تعداد پالس های انکودر به ازای یک دور کامک چرخش است.
- tick تعداد پالس های شمرده شده است.
- Round تعداد دورهای چرخانده شده است.
- Δt زمان چرخش چرخ به دنیقه است.

مقادیر به دست آمده از طریا پورت سریال به کامسیوتر ارسال می شود و با استفاده از نرم افزار MATLAB و ابزار Identification System به صورت تابع تبدیک سیستم تحلیک و مدل سازی می شود. تنظیمات مدل به صورت نطب تنها و بدون تاخیر در نظر گرفته می شود.

برای کنترل دنیا موتور، از کنترل کننده PID استفاده میشود. معادله کلی سیگنال کنترلی بر اسا مقدار خطای لحظه ای در رابطه و2-3 ذکر شده است:

∫ | و2-3 + ()pk = ()

t
0

(τ)dτ + kD

de(t)
dt

که در آن :

- (t(e تفاوت بین خروجی وانعی و مقدار مطلوب است.

k ، kp • I

و k به ترتیب برایب تناسبی، انتگرالی و مشتا گیری هستند که تاثیر هرکدام از جمفت
در سیگنال کنترلی را مشخد می کنند .

برای تنظیم برایب PID، از روش های مختلفی می توان استفاده کرد. یکی از روش ها زیگلر-نیکولز است که در آن ابتدا برایب مشتا گیر و انتگرالگیر صفر شده و بریب تناسبی افزایش داده میشود تا پاسخ سیستم سینوسی شود. سسس با استفاده از جدول مخصوح این روش، برایب کنترلی مورد نیاز به دست می آید. روش دیگر، استفاده از Tuner PID نرمافزار MATLAB است که در آن مدل سیستم به Tuner PID وارد شده و نوع کنترل کننده و برایب تنظیم می شوند . در این پروژه از روش دوم استفاده شده است.

با تنظیم برایب PID، کنترلکننده در میکروکنترلر پیادهسازی شده و با توجه به عملکرد ربات، تغییرات جزوی در برایب اعمال می شود. آزمایشهای مختلف شامک مسیرهای خطی به ربات داده می شود تا عملکرد آن در طی کردن مسیرها و رسیدن به هدف مشخد شده، ارزیابی گردد. برایب نهایی به دستآمده به صورت برای دو موتور چپ و راست در روابم و4-3 و و 5-3 به ترتیب ذکر شدهاند:

kp = 4, kI = 0.2, kD = 0.005
و4-3

kp = 4, kI = 0.25, kD = 0.005
و5-3
=بریب انتگرال | که در آن k بریب تناسبی،

گیر و k بریب مشتاگیر میباشد. زمان نمونه برداری نیز 10 میلیثانیه درنظر گرفته شدهاست.

### 2-2-3 کنترل موقعیت

| برای کنترل مونعیت ربات، ابتدا سییرعت زاویهای هر چرخ یعنی v وسییرعت چرخ راسییت و
وسرعت چرخ چپ اندازهگیری میشود. سسس این سرعتها به سرعت خطی تبدیک میشوند. برای انجام این تبدیک از رابطه و6-3 استفاده میشود:

vlinear =

vrotation
60

و6-3 π2 ×

در این رابطه:

- aenilv، سرعت خطی چرخ به واحد s/cm است.
- oitatorv، سرعت زاویهای چرخ به واحد rpm است.

- ، شعاع دایره به واحد cm است.

با اسیتفاده از این معادله، سیرعت خطی هر چرخ به دسیت میآید و میتوان تغییرات مونعیت ربات را بر اسیا این سیرعتها تخمین زد. سیسس با انتگرالگیری از سیرعت خطی هر چرخ، مسیافت طیشیده توسیم هر D) محاسیبه میشیود. پس از آن، میانگین مسیافت طیشیده توسیم چرخها(D) برای بروزرسیانی

چرخ (D و
مونعیت ربات به صیورت ذکر شیده در رابطه و7-3 محاسیبه میشیود. البته الزم به ذکر اسیت که پدیده دریفت میتواند در این روند محاسباتی اختفل ایجاد نماید :

DC =

DL+DR
2

و7-3
مونعیت جدید ربات در صییفحه با اسییتفاده از D و زاویه کنونی () طبا روابم و8-3 بروزرسییانی میشوند:
Δx = DC cos(φ) | 8-3و

Δy = DC sin(φ)
زاویه ربات نیز با اسیتفاده از تفابیک مسیافت طیشیده توسیم چرخها با توجه به فرمول و9-3 نابک محاسیبه است:

Δφ =

DR−DL
L

و9-3
در اینجیا، عرد ربیات اسیییت. این معیادالت سیییینمیاتیکی بیه تعیین مونعییت و زاوییه جیدیید ربیات پس از هر حرکت کمک میکنند .

براسیا مدل سیینماتیکی ربات ومدل دو چرخ یا Unicycle سیرعتهای لحظهای ربات به صیورت
ذکر شده در روابم و10-3 نابک تعریف میباشند:

و10-3 ()ocv = ̇
ẏ = vsin(φ)
φ̇ = ω
الزم به ذکر اسییت که در این مدل، و به ترتیب، سییرعت زاویهای کلی ربات و سییرعت خطی کلی ربات میباشند .برای تبدیک و به سرعت چرخها، از روابم و11-3 استفاده میشود:

و11-3 = ν

2v+ωL
2R
νL =

2v−ωL
2R
ν به ترتیب سرعت خطی چرخ راست و چپ، عرد ربات، شعاع چرخها است.

در اینجا νو

برای کنترل زاویه ω ربات، از یک کنترلکننده PID اسیتفاده میشیود. هدف این کنترلکننده رسییدن
اسییت که با توجه به مونعیت هدف محاسییبه می | به زاویه مطلوب
شییود. رابطهای که توسییم آن زاویه
چرخش الزم برای ربات را در لحظه محاسبه میکند در رابطهی و12-3 ذکر شده است:
−1tan = 1 t | و12-3
(

yd−y
xd−x

)

| در این رابطیه، x و y مختصیییات ربیات در دنییای بیرون میبیاشییید. برای اطمینیان از اینکیه زاوییه
در
محدوده [ ,−] نرار دارد، از رابطه و13-3 استفاده میشود:
−1tan t = | و13-3
(

sin (φt1)
cos (φt1)

)

در ارتباط با کنترلکنندهی PID طراحیشیده برای این بخش، از اختفف زاویه فعلی و این زاویه برای کنترل ربات استفاده میشود و برایب آن را میتوان در رابطه و14-3 مشاهده نمود:

و14-3 1.5 = k 0, = k 10, = k
برای کنترل سییرعت خطی ()، از یک کنترلکننده PID اسییتفاده میشییود که بر اسییا فاصییله بانیمانده تا هدف عمک میکند و خطای موجود تحت رابطه فاصیله انلیدسیی که در و15-3 ذکر شیده اسیت محاسبه میشود:

d = √(xd − x)
2 + (yd − y)

و15-3 ²

این کنترلکننیده بیه کیاهش سیییرعیت ربیات بیا نزدییکشیییدن بیه هیدف کمیک میکنید تیا از بیاالزدگی جلوگیری شود.برایب این کنترلکننده در رابطهی و16-3 آمدهاست:

kp = 8, kI = 2, kD = 1.5
و16-3
با اسیتفاده از این روش ها و بهکارگیری چهار کنترلکننده ودو کنترلکننده برای سیرعت چرخها، یکی برای سییرعت زاویهای و یکی برای سییرعت خطی، ربات میتواند بهصییورت دنیا به مونعیت هد ف (y ,x) برسد .

### 3-2-3 کنترل جهت نهایی

هنگامی که ربات به مونعیت(y ,x) مطلوب می رسد، الزم است که ربات جهتگیری خود را به زاویه
φ تنظیم کند. برای انجام این کار، ربات باید در جای خود بچرخد بدون اینکه به صورت خطی جابجا شود. این فرآیند شامک حرکت وارون دو چرخ به طور همزمان است تا سرعت خطی به صفر برسد و فقم سرعت

زاویه ای تغییر کند . برای این منظور، سویچی برای فیدبک زاویه درنظر گرفته شدهاست که ونتی خطای فاصله φ، به به مقدار φ تغییر می کند .
کمتر از مقدار مشخصی ودر این پروژه، 5 سانتیمتر از هدف نرارگفت،

در این حالت، دو چرخ به صورت برعکس از یکدیگر حرکت می کنند، یعنی چرخ راست با سرعتν به
ν به عقب می چرخد. از آنجا که ربات نیازی به جابجایی خطی ندارد، سرعت خطی
جلو و چرخ چپ با سرعت
ربات صفر می شود. اما سرعت زاویه ای هنوز باید تغییر کند تا زاویه φ حاصک شود. این تغییر زاویه به وسیله
| تفاوت سرعت چرخ ها ایجاد میشود. برای دستیابی به این هدف، رابطه بین ν و
به صورت ذکر شده در
روابم و17-3 محاسبه میشوند:

و17-3 = ν

ωL
2R
νL =

−ωL
2R
ν به ترتیب سرعت خطی چرخ راست و چپ، عرد ربات، شعاع چرخها است.

در اینجا νو

با این تنظیمات، ربات به صورت درجا می چرخد تا به زاویه φ برسد. پس از رسیدن به زاویه نهایی، سرعت زاویه ای صفر می شود و ربات در مونعیت و جهتگیری مطلوب خود نرار می گیرد.

### 3-3 کنترل الیه باال

ربات دارای دو رفتار اصییلی اسییت: حرکت به سییمت هدف نهایی و اجتناب از موانع. این دو رفتار بر
اسیا اطفعات دریافتی از حسیگرها و پردازش های الیه باالیی به صیورت متناوب مدیریت و کنترل میشیوند. در حالت عادی، ربات به سیمت هدف مشیخدشده(φ,y ,x) حرکت میکند، به طوری که هدف اصلی آن رسییدن به مقصید نهایی تعیینشیده اسیت. اما به محا اینکه یکی از حسیگرها مانعی را در مسییر شیناسیایی کند، ربات بهطور خودکار رفتار خود را تغییر داده و وارد فاز اجتناب از مانع میشود. در این فاز، ربات به جای حرکت مسیتقیم به سیمت هدف، بر اسیا اطفعات حسیگرهای فراصیوت و دوربین، مسییر جدیدی را برای دور زدن مانع انتخاب کرده و پس از عبور از آن، مجدداً به سمت مقصد اصلی حرکت میکند.

### 1-3-3 توقف در مقابل مانع و فرآیند اجتناب از مانع

در الیه باالیی، ربات مجهز به سیه حسیگر فراصیوت اسیت که در سیمت چپ، جلو و راسیت ربات نرار گرفتهاند. این حسیگ رها به منظور شیناسیایی موانع در مسییر ربات مورد اسیتفاده نرار میگیرند. زمانی که یکی

از حسیگرها مانعی با فاصیله کمتر از 20 سیانتیمتر را شیناسیایی کند، بففاصیله سییگنالی به الیه پایین ارسیال میشود که باعث تونف ربات میگردد و ربات وارد فاز اجتناب از مانع میشود.

در این مرحله، با اسییتفاده از دوربینی که به ربات متصییک اسییت و توسییم پردازش تصییویر و تحلیک مونعیتهای اطراف، ربات نادر اسیت بهترین زاویه را برای اجتناب از مانع محاسیبه کند. همچنین، با خواندن مقادیر حسییگرهای چپ و راسییت فراصییوت، ربات اطفعات مربوط به موانع اطراف را تکمیک میکند. در این فرآیند، 7 زاویه مختلف برای حرکت محاسییبه میشییود: 5 زاویه از طریا چرخش دوربین که توسییم سییروو موتور کنترل میشود و 2 زاویه از مقادیر جسگرهای فراصوت چپ و راست به دست میآید .

سیسس بهترین زاویه توسیم این 7 زاویه محاسیبه میشیود. الیه باال با ارسیال دسیتور به الیه پایین، ربات
را به سییمت این زاویه مناسییب برای دور زدن مانع هدایت میکند. پس از چرخش به زاویه مطلوب، ربات به مدت کوتاهی وبه اندازه 20 سانتیمتر به سمت جدید حرکت میکند تا از مانع عبور کند . پس از اتمام این فاز و دور شیدن از مانع، الیه باال مجدداً دسیتوری به الیه پایین ارسیال میکند تا ربات
به مسییر اصیلی خود بازگردد و به سیمت هدف نهایی حرکت کند. این فرآیند به صیورت پیوسیته انجام میشیود تا ربات به طور موثر از موانع موجود در مسیر خود اجتناب کند و در نهایت به مقصد نهایی خود برسد .

### 2-3-3 فاصلهسنجی با استفاده از دوربین

محاسبه فاصله از جسم با استفاده از تصاویر دوبعدی یکی از چالشهای اصلی در کنترل ربات با استفاده
از دوربین است. روش های متعددی برای به دست آوردن فاصله تا جسم در تصاویر دوبعدی وجود دارند، از جمله استفاده از نقطه محوشدن در تصویر [6]، مقایسه دو تصویر پشت سر هم [7]، و روش های دیگ ر. با این حال، اغلب این روش ها دارای حجم محاسباتی باال هستند و نمی توانند به صورت بی درنگ عمک کنند .

طبا مرجع [8]، نسبت دستگاه مختصات دوربین به دستگاه مختصات دنیای وانعی میتواند با استفاده
از دو دستگاه مختصات سه بعدی توصیف شود. همانطور که در شکک 2-3 نشان داده شده، چگونگی انعکا دنیای سه بعدی بر روی صفحه تصویر دوبعدی را می توان مشاهده کرد.

با استفاده از تشابهات و نسبتهای مرلراتی، فاصله جسم تا دوربین را در تصاویر دوبعدی به دست آورده می -.ش ود که رابطه و18-3 این مورد را بیان میکند:

distance =

fmmHOmHIMGp

HOpHSmm

و18-3

که در آن fmm فاصله کانونی دوربین، HOm ارتفاع دوربین از سطح زمین به متر، HIMGp طول تصویر به پیکسک، HOp طول جسم به پیکسک و HSmm

اندازه حسگر به میلی متر میباشد. تنها ورودی معلوم این الگوریتم
فاصله دوربین از زمین است.

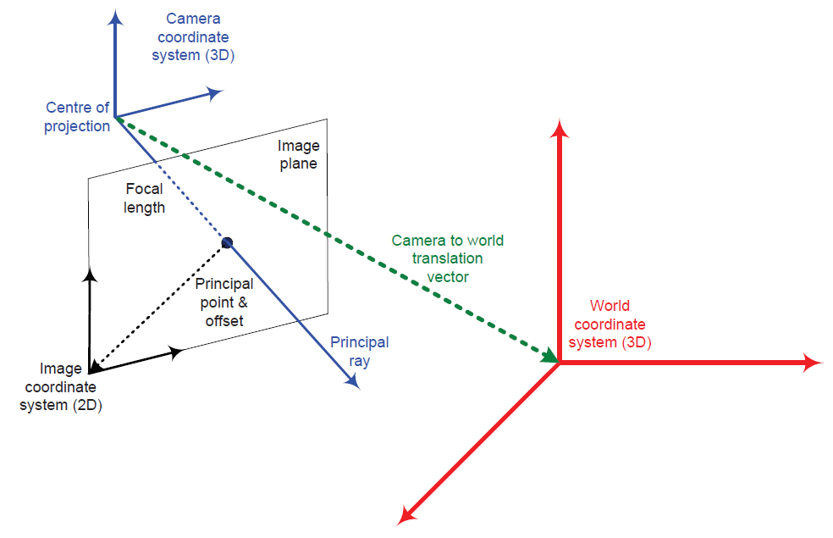
[picture p30: figure]

شکک :2-3 نمایش انعکا دنیای سهبعدی برروی صفحه تصویر دوبعدی.

برای تشخید جسم درون تصویر، از الگوریتم detection edge Canny استفاده شده است. این الگوریتم که در کتابخانه OpenCV پیادهسازی شده است، لبه های اجسام را با تشخید تغییرات ناگهانی در شدت نور پیکسکها مشخد می کند . مراحک الگوریتم Canny به این شر) است:

.1 تبدیک تصویر به مقیا خاکستری: ابتدا تصویر رنگی به یک تصویر سیاه و سفید تبدیک می شود تا شدت نور پیکسکها ساده تر بررسی شود.

.2 اعمال فیلتر گوس ی: برای کاهش نویز و صاف کردن تصویر، فیلتر گوسی اعمال می شود. این فیلتر با محاسبه میانگین وزنی پیکسکهای مجاور، نویز را کاهش داده و از ایجاد لبه های کاذب جلوگیری می کند .

.3 محاسبه گرادیان تصویر: پس از کاهش نویز، گرادیان تصویر که نمایانگر تغییرات ناگهانی در شدت نور است محاسبه می شود. این گرادیان در دو جهت x و y بهدست می آید و بزرگی و زاویه گرادیان نیز طبا روابم و 19-3 محاسبه میشود:

G = √(Gy)
2
+ (Gx

)

و 19-3 ²

θ = tan⁻¹
(

Gy
Gx

)

.4 نابودی غیر حداکرری: در این مرحله لبه ها نازک می شوند. تنها پیکسکهایی که دارای بیشترین مقدار گرادیان نسبت به همسایگان خود در جهت گرادیان هستند، به عنوان لبه نگه داشته میشوند و بقیه پیکسکها حذف می گردند .

.5 آستانهگذاری با هیسترزیس: در این مرحله، دو آستانه باال و پایین برای انتخاب لبه ها اعمال میشود. لبه هایی که مقدار گرادیانشان باالتر از آستانه باال باشد، به عنوان لبه های نوی در نظر گرفته می شوند
و پیکسک هایی که بین آستانه باال و پایین نرار دارند، در صورتی که به لبه های نوی متصک باشند، نگه
داشته می شوند

با استفاده از این الگوریتم و مختصات اجسام موجود در تصویر، می توان اطفعاتی مانند ابعاد جسم به پیکسک و فاصله جسم از دوربین را استخراج کرد و این اطفعات در پردازش های بعدی برای هدایت ربات و اجتناب از موانع مورد استفاده نرار می گیرند .

### 3-3-3 بهترین زاویه خروج

روش اراوهشیده به عنوان »الگوریتم بازتاب حبابی

6
« نامیده میشیود [9]. طبا این الگوریتم، تنها موانع
7 | شیناسیاییشیده در ناحیهای به نام »حباب حسیاسییت
« اطراف ربات مورد نظر نرار میگیرند. شیکک و اندازه
حباب حسیاسییت به طور دینامیک با توجه به حرکات ربات تنظیم میشیود. با شیناسیایی مانع، ربات در جهتی که کمترین تراکم موانع وجود دارد، تغییر جهت میدهد و حرکت خود را در این جهت ادامه میدهد .

ربات برای تعیین بهترین زاویه خروج از مانع، فاصیله تا مانع را در 7 زاویه مختلف بررسیی میکند. این زوایا شامک ،-90 ،-60 ،-30 ،0 ،30 60 و 90 درجه هستند. زوایای 90 و -90 درجه با استفاده از حسگرهای فراصیوت اندازهگیری میشیوند، در حالی که برای زوایای دیگر، سیروو موتور دوربین را میچرخاند تا فاصیله را در آن زاویه خاح اندازهگیری کند. در صیورتی که فاصیله جسیم بیشیتر از 20 سیانتیمتر باشید، مقدار 20 سانتیمتر به عنوان فاصله در نظر گرفته میشود.

برای محاسبه بهترین زاویه خروج، از رابطه و20-3 استفاده میشود [9]:

αR =

∑ αiDi

7
i=1
∑ Di

7
| i=1

و20-3

6 Bubble Rebound Algorithm

7
Sensitivity Bubble

ای که حسیگر در آن نسیبت به ربات | زاویه | فاصیله تشیخید دادهشیده توسیم حسیگر iام، | | در این رابطه،
نرار گرفتهاست میباشد.α نیز میزان چرخش مناسب برای ربات در جهت اجتناب از مانع است.

مزایای این روش عبارتند از:

- نیاز به بار محاسباتی بسیار کم دارد و میتواند بر روی میکروکنترلرهای کمهزینه پیادهسازی شود.
- نادر به اجتناب از موانع ثابت و حتی برخی موانع متحرک، مانند افراد در حال راه رفتن است.
- به حسگرهای کمهزینه نیاز دارد.
- به راحتی میتوان آن را برای حسگرهای دیگر، مانند لیزرهای چرخشی، سازگار کرد.

با این حال، بعفهای عمده این روش به شر) زیر است:

- این روش به دور از بهینه بودن است.
- مانند بیشییتر الگوریتمهای صییرفاً واکنشییی، نیاز به یک برنامهریز مسیییر در سییطح باالتر دارد تا در محیم های شبیه به هزارتو به خوبی عمک کند. به عنوان مرال، ممکن است الگوریتم نتواند ربات را از نقطه شییروع به هدف نهایی هدایت کند، مگر اینکه یک برنامهریز بتواند هدف میاندسییتی را تعیین کند .
- حرکت نرم و یکنواخت نیست.
- حرکت حتی اگر مسیر به هدف وجود نداشته باشد، تفش میشود.

## فصل :4 نتایج عملی

3⁵

### 1-4 مقدمه

در فصکهای گذشته نحوه ساخت بخشهای مکانیکی و الکترونیکی و طراحی کنترل کننده و الگوریتم-
های عبور از موانع بررسی شد. در این فصک، به اراوه و تحلیک نتایج آزمایشگاهی پرداخته خواهد شد. در این بخش ابتدا تستهای مسیر بدون مانع و سسس تستهای مسیر باوجود موانع بررسی شده است. در انتهای این گزارش نیز، به بررسی چالش های بانیمانده و اراوه پیشنهادات و راهحکهای احتمالی پرداخته میشود.

در این آزمایشها زمان نمونهبرداری 10 میلی ثانیه درنظر گرفتهشده و از برایب کنترل کننده گزارش -
ش ده در بخش نبک استفاده شدهاست.

### 2-4 طی کردن مسیر بدون مانع و رفتن به هدف

در این بخش کنترل حرکت ربات در الیه پایین مورد بررسی نرار میگیرد. با استفاده از پایتون بر روی رزبریپای، از طریا ارتباط سریال، به آردوینو دستورات داده میشود. برای بررسی عملکرد سیستم سه حالت متفاوت بررسی شدهاست. در این بخش گزارش برای بیان مونعیت ربات از نوشتار زیر استفاده شدهاست:

(x, y,φ)
برای این که در عمک، ربات بتواند بعد از رسیدن به هدف متونف شود، دو شرط همواره بررسی میشوند
تا ربات بتواند متونف شوند که شرط اول کمتر شدن فاصله انلیدسی کمتر از 5 سانتی متر و شرط دوم کمتر شدن خطای زاویه نهایی از 6 درجه است.

### 1-2-4 حالت اول

در این حالت، ربات باید از حالت (0,0,0) به هدف (100,0,0) برسیید. شییکک 1-4 نمایی از مسیییر حرکت ربات را نشیان میدهد و شیککهای ،2-4 ،3-4 4-4 و 5-4 نمودارهای مونعیت ربات و سییگنالهای کنترلی اعمالشییده به موتورهای راسییت و چپ ربات را نشییان میدهند. برای مونعیتیابی ربات، از دادههای انکودر استفاده شدهاست.

همانطور که مشاهده میشود ربات به خوبی مسیر را طی کرده و با خطایی بسیار جزوی به هدف در نقطه و 100,0,0 رسیدهاست.

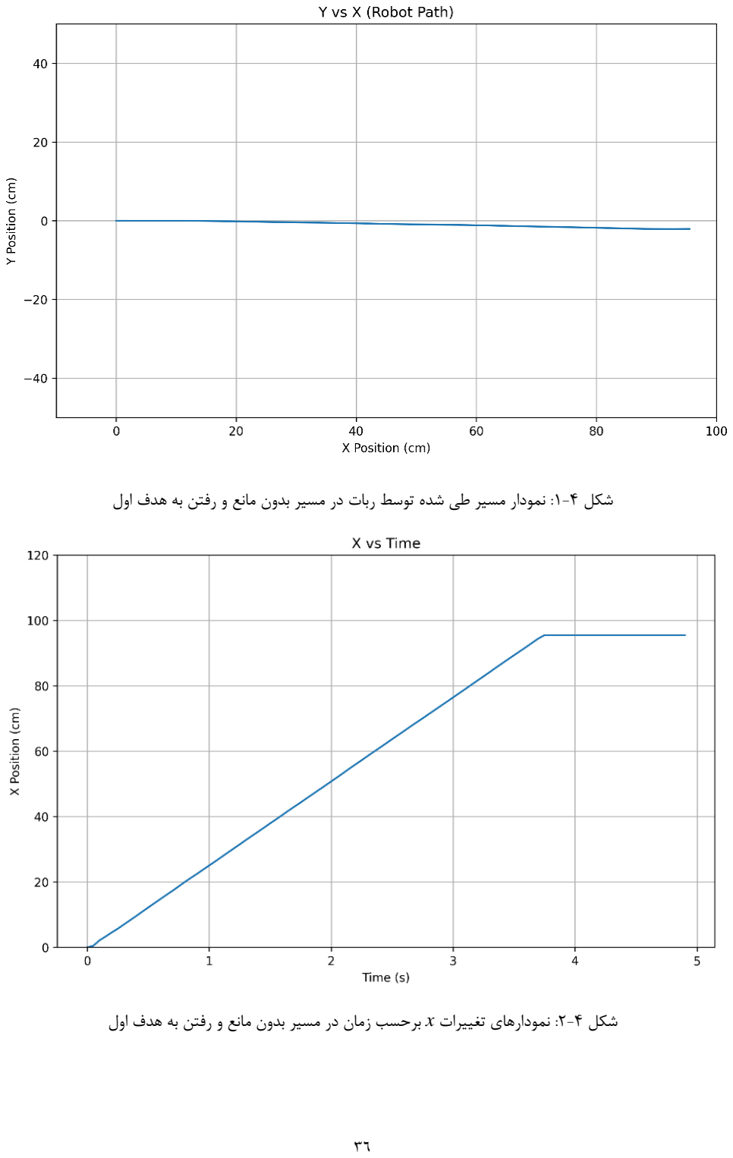
[picture p31: page 49]

شکک :1-4 نمودار مسیر طی شده توسم ربات در مسیر بدون مانع و رفتن به هدف اول

شکک :2-4 نمودارهای تغییرات x برحسب زمان در مسیر بدون مانع و رفتن به هدف اول

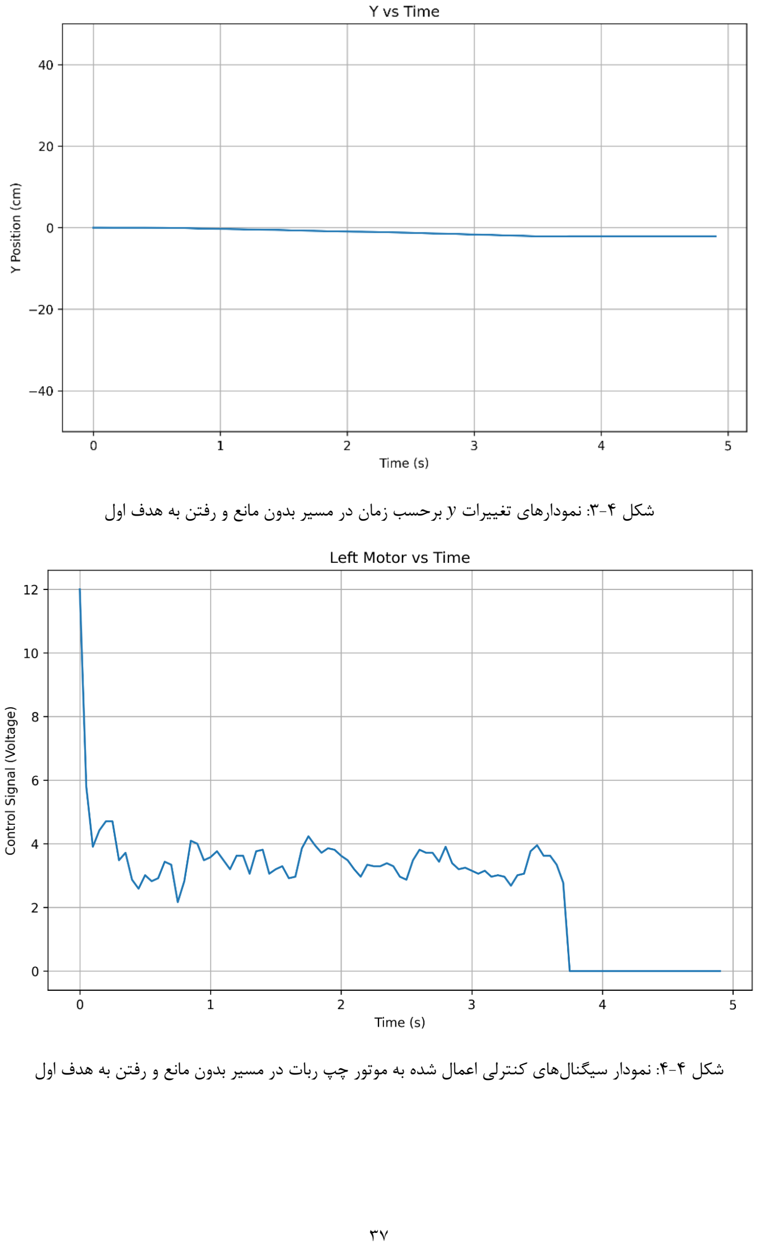
[picture p32: page 50]

شکک :3-4 نمودارهای تغییرات y برحسب زمان در مسیر بدون مانع و رفتن به هدف اول

شکک :4-4 نمودار سیگنالهای کنترلی اعمال شده به موتور چپ ربات در مسیر بدون مانع و رفتن به هدف اول

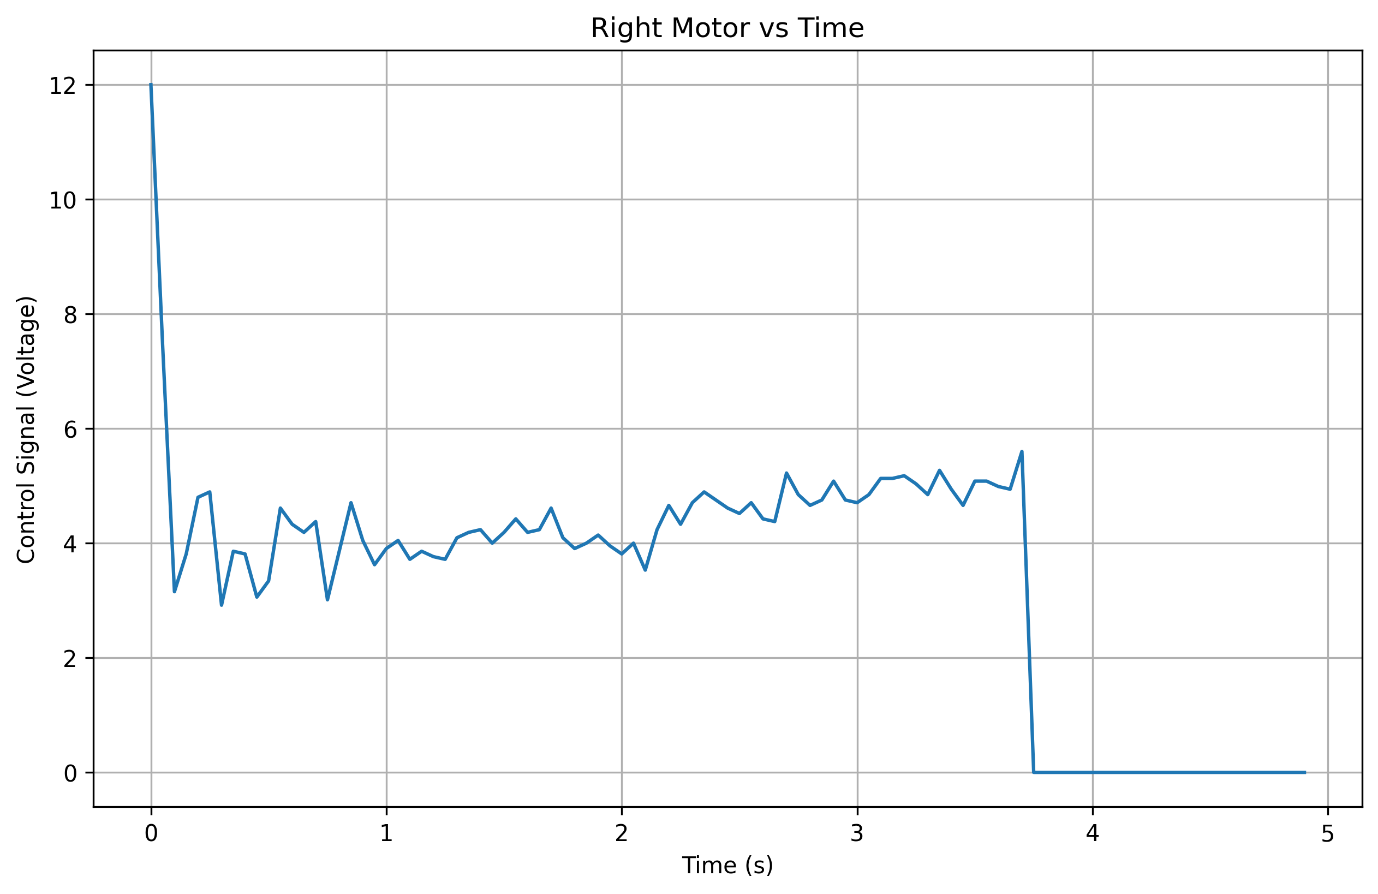
[picture p33: figure]

شکک :5-4 نمودار سیگنالهای کنترلی اعمال شده به موتور راست ربات در مسیر بدون مانع و رفتن به هدف اول

### 2-2-4 حالت دوم

در این حالت، ربات باید از حالت (0,0,0) به هدف (100,-50,0) برسد. شکک 6-4 نمایی از مسیر حرکت ربات را نشان می دهد و و شککهای ،7-4 -4 ،8 -4 9 و -4 10 نمودارهای مونعیت ربات و سیگنالهای کنترلی اعمالشده به موتورهای راست و چپ ربات را نشان میدهند. برای مونعیتیابی ربات، از دادههای انکودر استفاده شدهاست.

همانطور که مشاهده میشود ربات به خوبی مسیر را طی کرده و با خطایی بسیار جزوی به هدف در نقطه و100,-50,0 رسیدهاست. الزم به ذکر است که بعد از رسیدن به x و y مناسب، تغییر زاویه و درجا زدن ربات نابک مشاهده است.

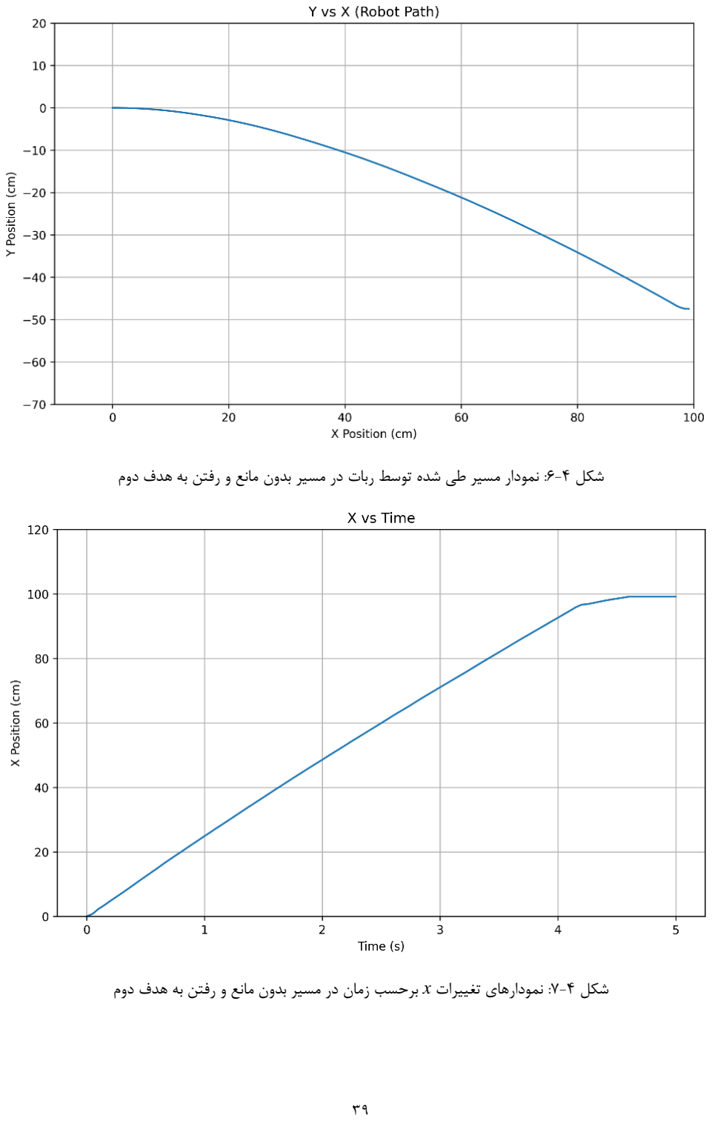
[picture p34: page 52]

شکک :6-4 نمودار مسیر طی شده توسم ربات در مسیر بدون مانع و رفتن به هدف دوم

شکک :7-4 نمودارهای تغییرات x برحسب زمان در مسیر بدون مانع و رفتن به هدف دوم

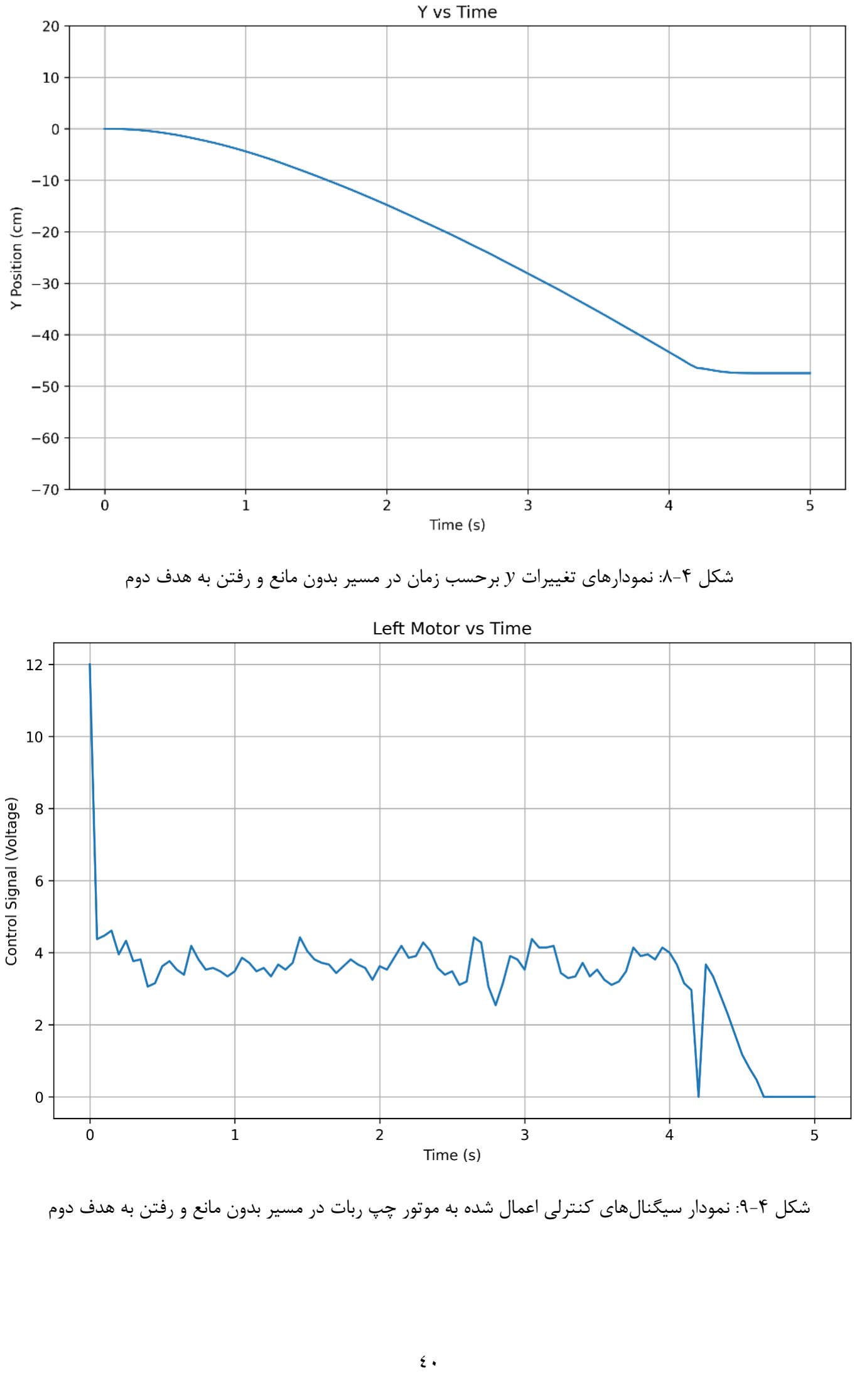
[picture p35: page 53]

شکک :8-4 نمودارهای تغییرات y برحسب زمان در مسیر بدون مانع و رفتن به هدف دوم

شکک :9-4 نمودار سیگنالهای کنترلی اعمال شده به موتور چپ ربات در مسیر بدون مانع و رفتن به هدف دوم

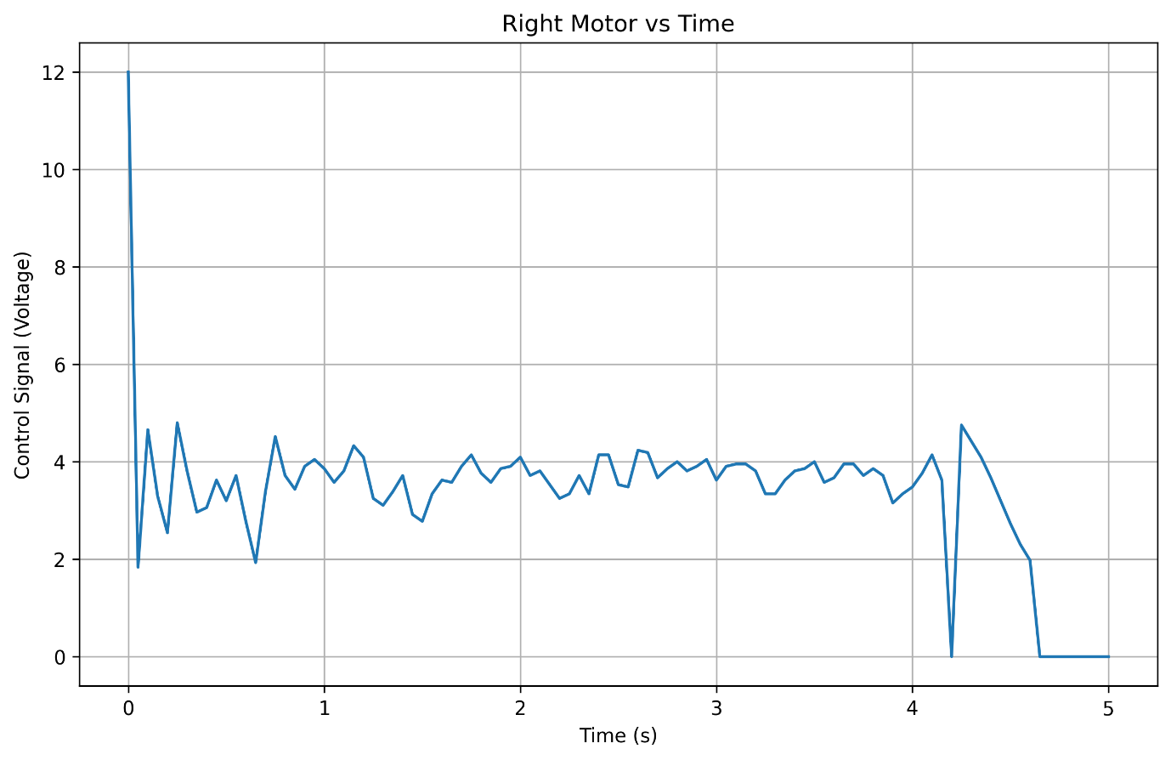
[picture p36: figure]

شکک :10-4 نمودار سیگنالهای کنترلی اعمال شده به موتور راست ربات در مسیر بدون مانع و رفتن به هدف دوم

### 3-2-4 حالت سوم

در این حالت، ربات باید از حالت (0,0,0) به هدف (0,100,0) برسد. شکک 11-4 نمایی از مسیر حرکت ربات را نشان میدهد و شککهای ،12-4 ،13-4 14-4 و -4 15 نمودارهای مونعیت ربات و سیگنال-های کنترلی اعمالشده به موتورهای راست و چپ ربات را نشان میدهند. برای مونعیتیابی ربات، از دادههای انکودر استفاده شدهاست.

همانطور که مشاهده میشود ربات به خوبی مسیر را طی کرده و با خطایی بسیار جزوی به هدف در نقطه و0,100,0 رسیدهاست. الزم به ذکر است که بعد از رسیدن به x و y مناسب، تغییر زاویه و درجا زدن ربات نابک مشاهده است.

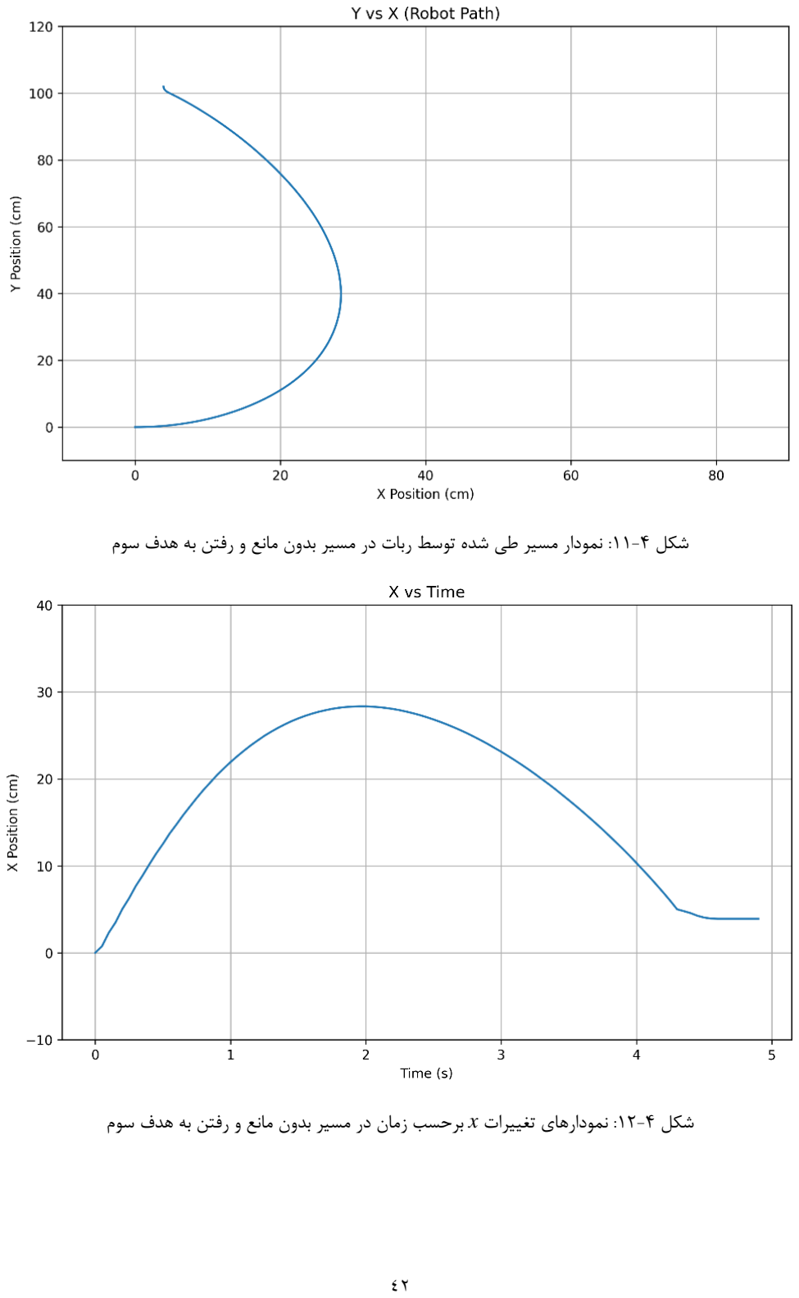
[picture p37: page 55]

شکک :11-4 نمودار مسیر طی شده توسم ربات در مسیر بدون مانع و رفتن به هدف سوم

شکک :12-4 نمودارهای تغییرات x برحسب زمان در مسیر بدون مانع و رفتن به هدف سوم

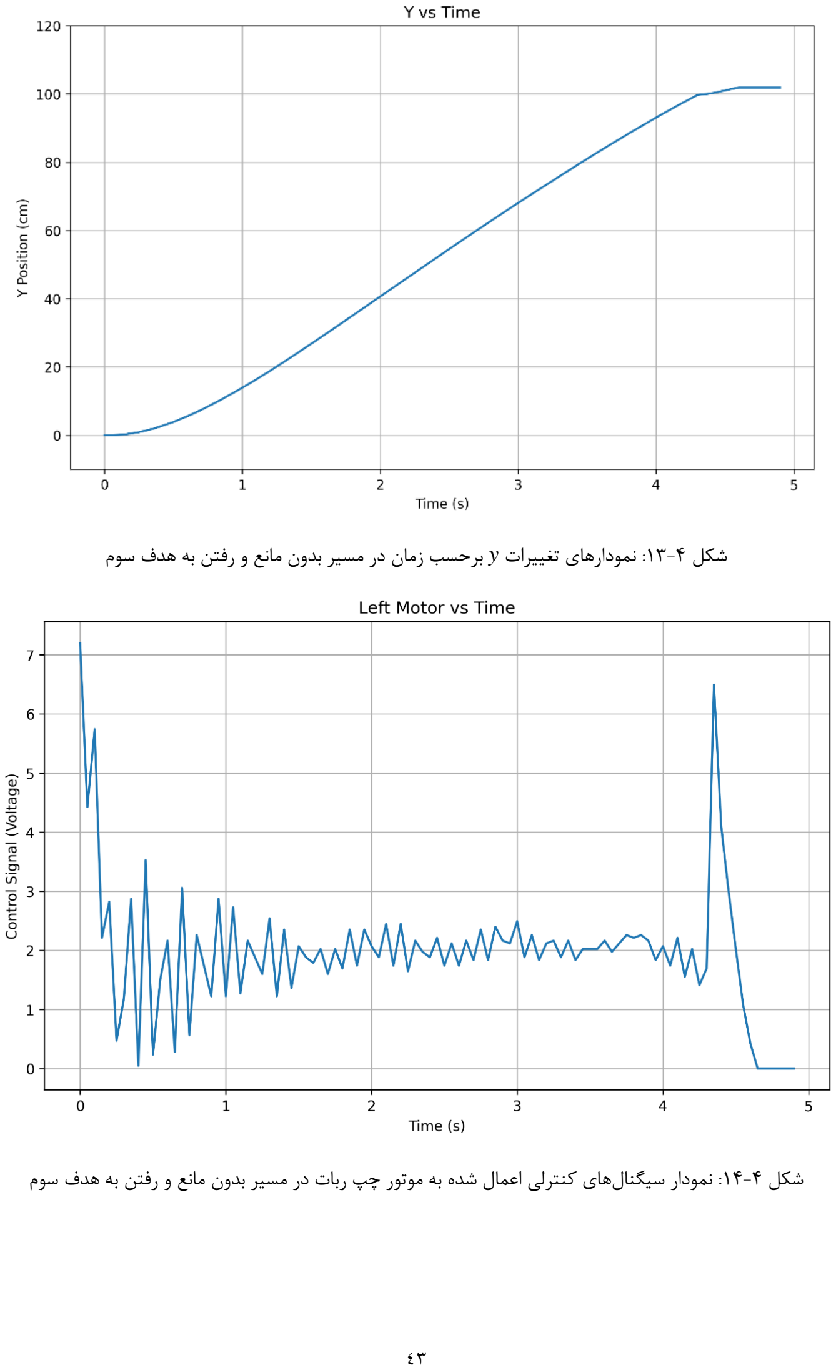
[picture p38: page 56]

شکک :13-4 نمودارهای تغییرات y برحسب زمان در مسیر بدون مانع و رفتن به هدف سوم

شکک :14-4 نمودار سیگنالهای کنترلی اعمال شده به موتور چپ ربات در مسیر بدون مانع و رفتن به هدف سوم

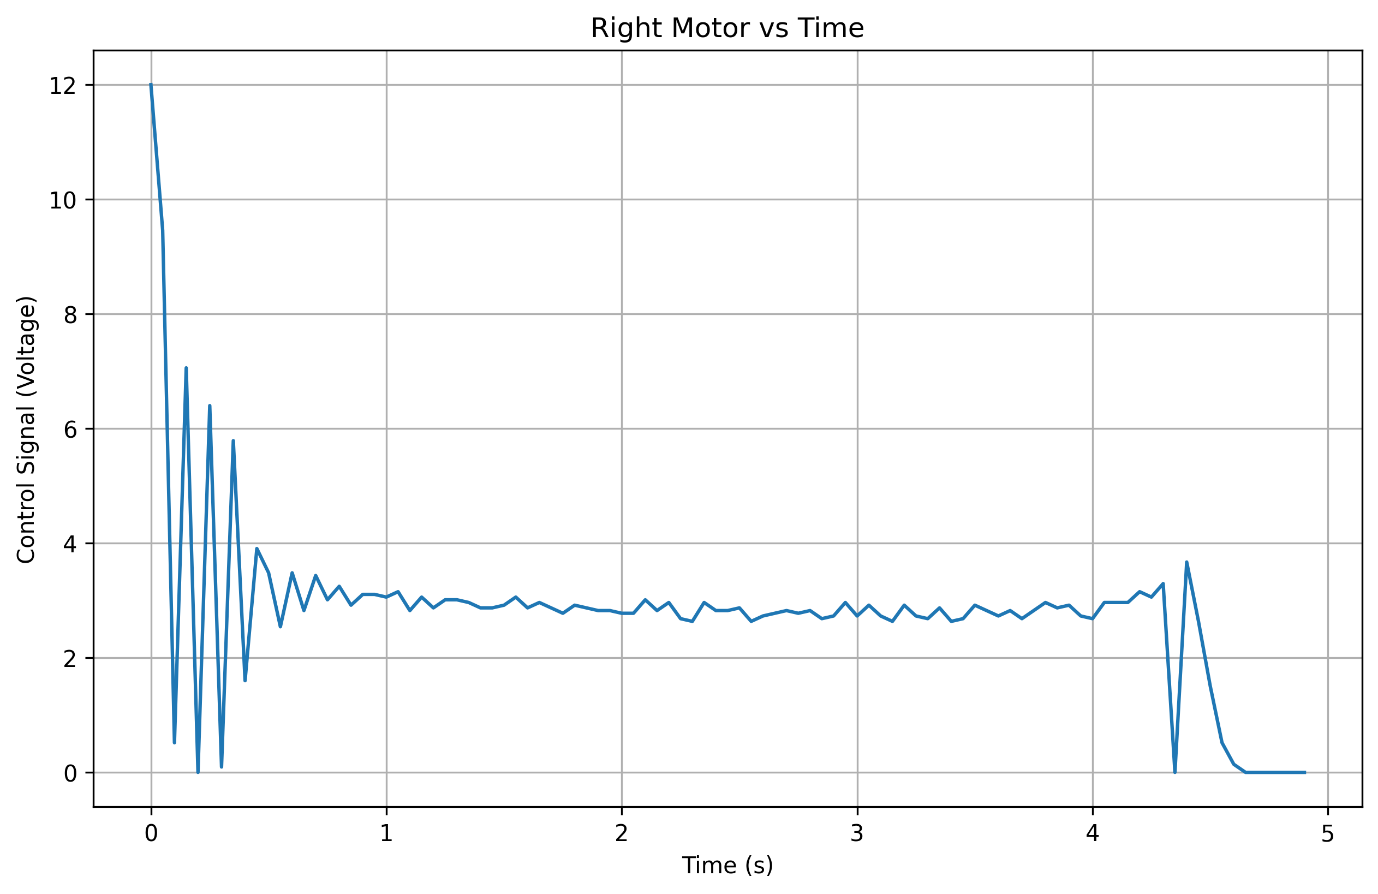
[picture p39: figure]

شکک :15-4 نمودار سیگنالهای کنترلی اعمال شده به موتور راست ربات در مسیر بدون مانع و رفتن به هدف سوم

### 3-4 طی کردن مسیر با مانع

در این بخش کنترل حرکت ربات در الیه باال مورد بررسی نرار می گیرد. با استفاده از برنامه پایتون بر
روی رزبریپای، از طریا ارتباط سریال، به آردوینو دستورات داده میشود. مانعها در دو حالت در مسیر حرکت ربات نرار میگیرند که مورد اول ربات باید از سمت چپ و در حالت بعدی از میان آنها حرکت کند.

### 1-3-4 دور زدن مانعها

در این حالت، ربات باید از حالت (0,0) به هدف (200,0) برسد. سه مانع در مسیر مستقیم
ربات نرار گرفتهاست. شکک 16-4 نمایی از مسیر حرکت ربات را نشان میدهد و شککهای ،17-4 -4 ،18 -4 19 و -4 20 نمودارهای مونعیت ربات و سیگنالهای کنترلی اعمالشده به موتورهای راست و چپ ربات را نشان میدهند. برای مونعیت یابی ربات، از دادههای انکودر استفاده شدهاست. از حسگرهای فراصوت و دوربین نیز برای فاصلهسنجی تا موانع استفاده شده است. در نمودار و16-4 نقاطی که موانع در آن نرار گرفتهاند نیز با یک بربدر نمایش داده شدهاند.

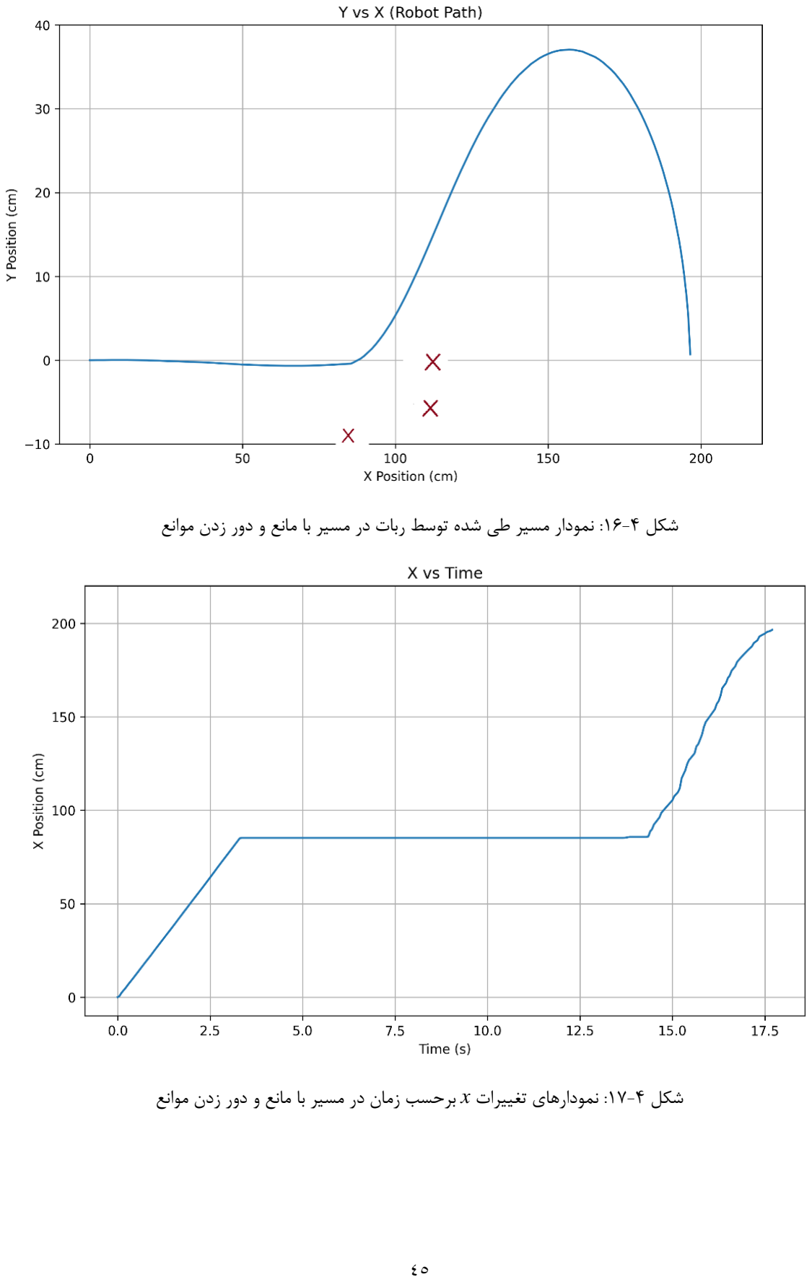
[picture p40: page 58]

4⁵

شکک :16-4 نمودار مسیر طی شده توسم ربات در مسیر با مانع و دور زدن موانع

شکک :17-4 نمودارهای تغییرات x برحسب زمان در مسیر با مانع و دور زدن موانع

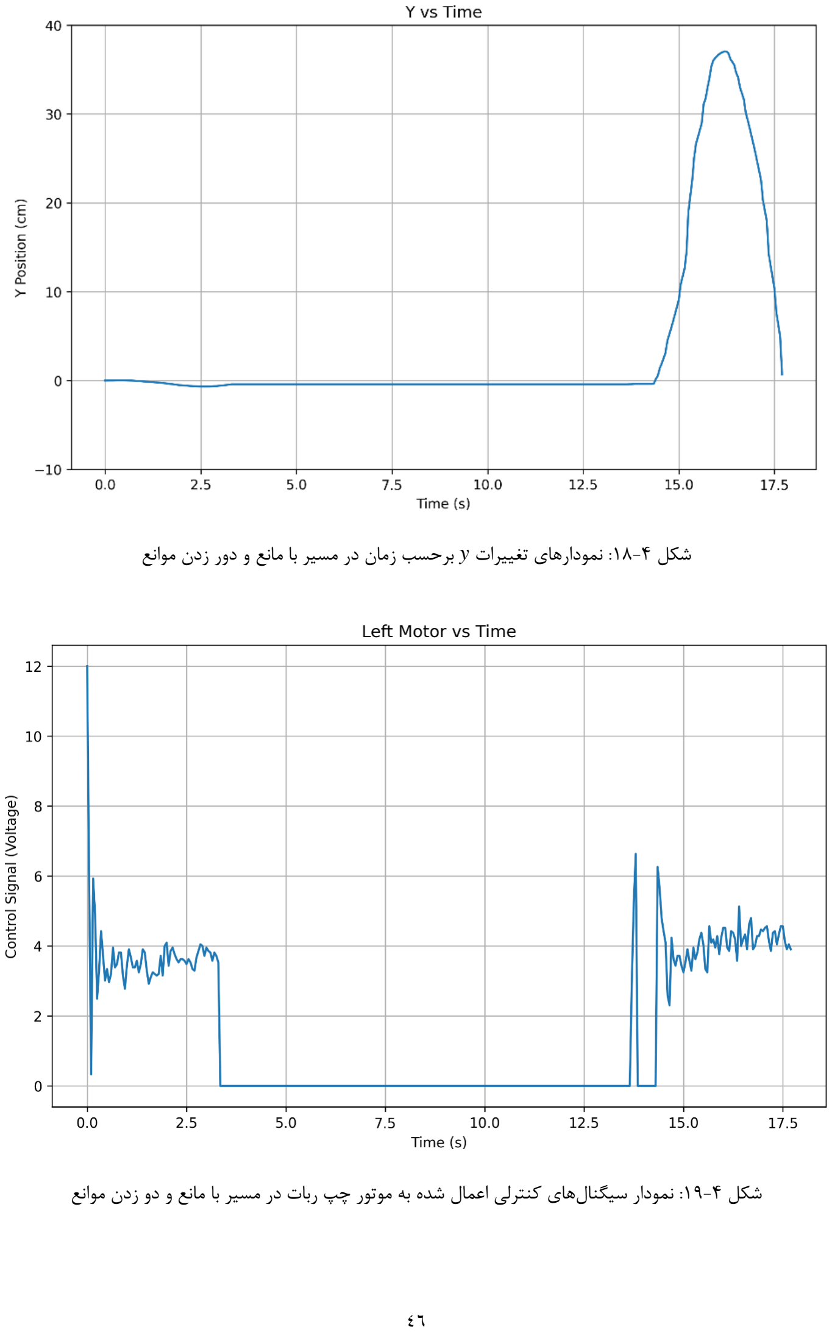
[picture p41: page 59]

شکک :18-4 نمودارهای تغییرات y برحسب زمان در مسیر با مانع و دور زدن موانع

شکک :19-4 نمودار سیگنالهای کنترلی اعمال شده به موتور چپ ربات در مسیر با مانع و دو زدن موانع

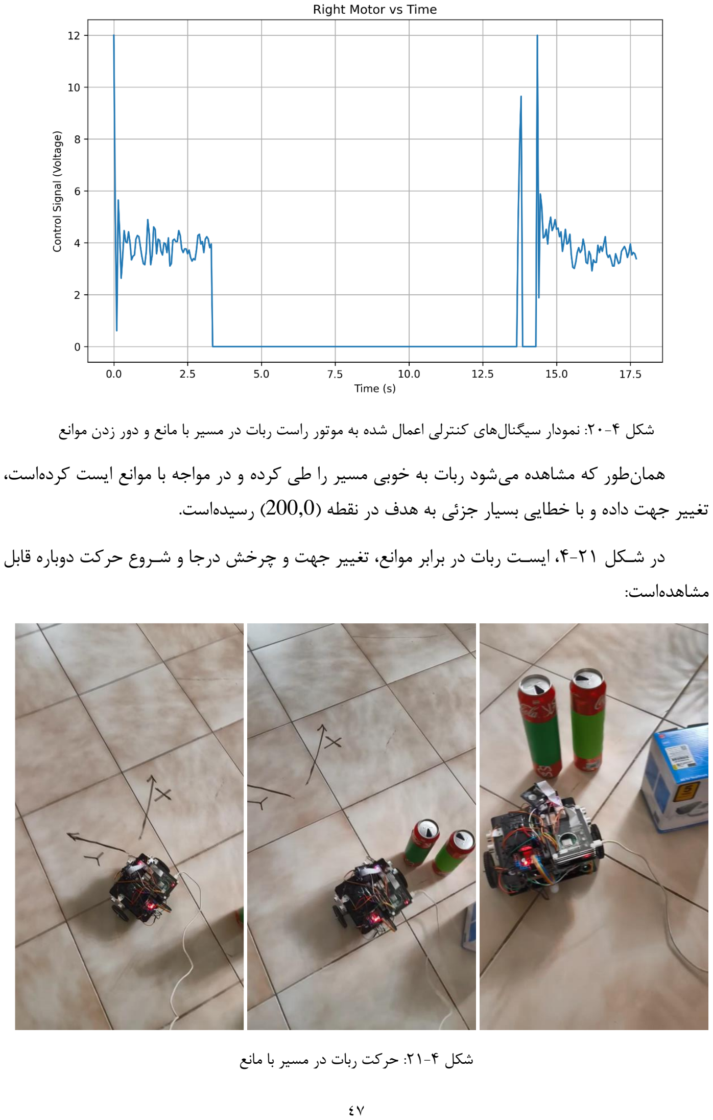
[picture p42: page 60]

شکک :20-4 نمودار سیگنالهای کنترلی اعمال شده به موتور راست ربات در مسیر با مانع و دور زدن موانع
همانطور که مشاهده میشود ربات به خوبی مسیر را طی کرده و در مواجه با موانع ایست کردهاست، تغییر جهت داده و با خطایی بسیار جزوی به هدف در نقطه و200,0 رسیدهاست.

در شیکک ،4-21 ایسیت ربات در برابر موانع، تغییر جهت و چرخش درجا و شیروع حرکت دوباره نابک مشاهدهاست:

شکک :21-4 حرکت ربات در مسیر با مانع

### 2-3-4 حرکت از بین مانعها

در این حالت، ربات باید از حالت (0,0) به هدف (150,0) برسد. دو مانع در مسیر ربات نرار گرفتهاست
ولی ربات میتواند از بین آن دو حرکت کند و فاصله ی حبابی را حفظ کند . شکک 22-4 نمایی از مسیر حرکت ربات را نشان میدهد و شککهای -4 ،23 ،24-4 25-4 و 26-4 نمودارهای مونعیت ربات و سیگنالهای کنترلی اعمالشده به موتورهای راست و چپ ربات را نشان میدهند. برای مونعیتیابی ربات، از دادههای انکودر استفاده شدهاست. از حسگرهای فراصوت و دوربین نیز برای فاصلهسنجی تا موانع استفاده شده است. در نمودار و 22-4 نقاطی که موانع در آن نرار گرفتهاند نیز با یک بربدر نمایش داده شدهاند .

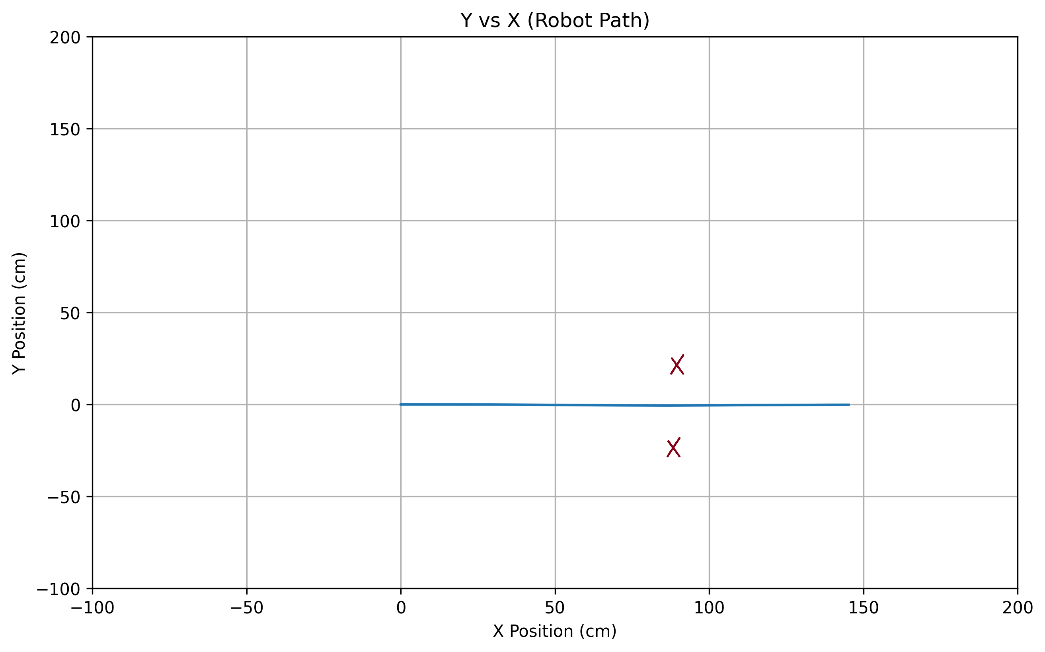
[picture p43: figure]

شکک :22-4 نمودار مسیر طی شده توسم ربات در مسیر با مانع و حرکت از بین موانع

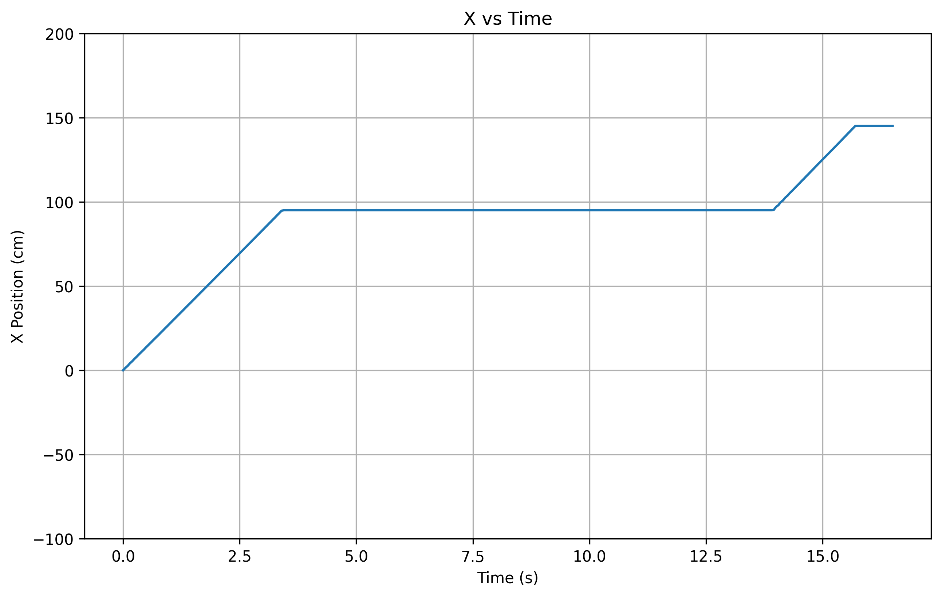
[picture p44: figure]

شکک :23-4 نمودارهای تغییرات x برحسب زمان در مسیر با مانع و حرکت از بین موانع

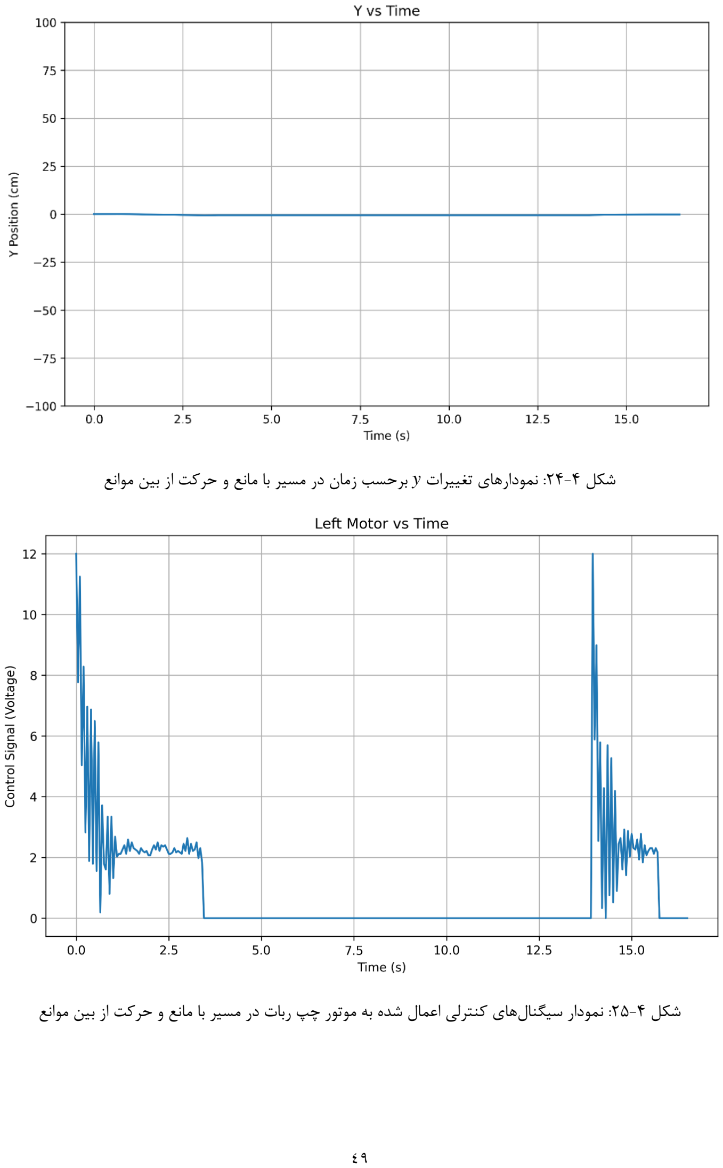
[picture p45: page 62]

شکک :24-4 نمودارهای تغییرات y برحسب زمان در مسیر با مانع و حرکت از بین موانع

شکک :25-4 نمودار سیگنالهای کنترلی اعمال شده به موتور چپ ربات در مسیر با مانع و حرکت از بین موانع

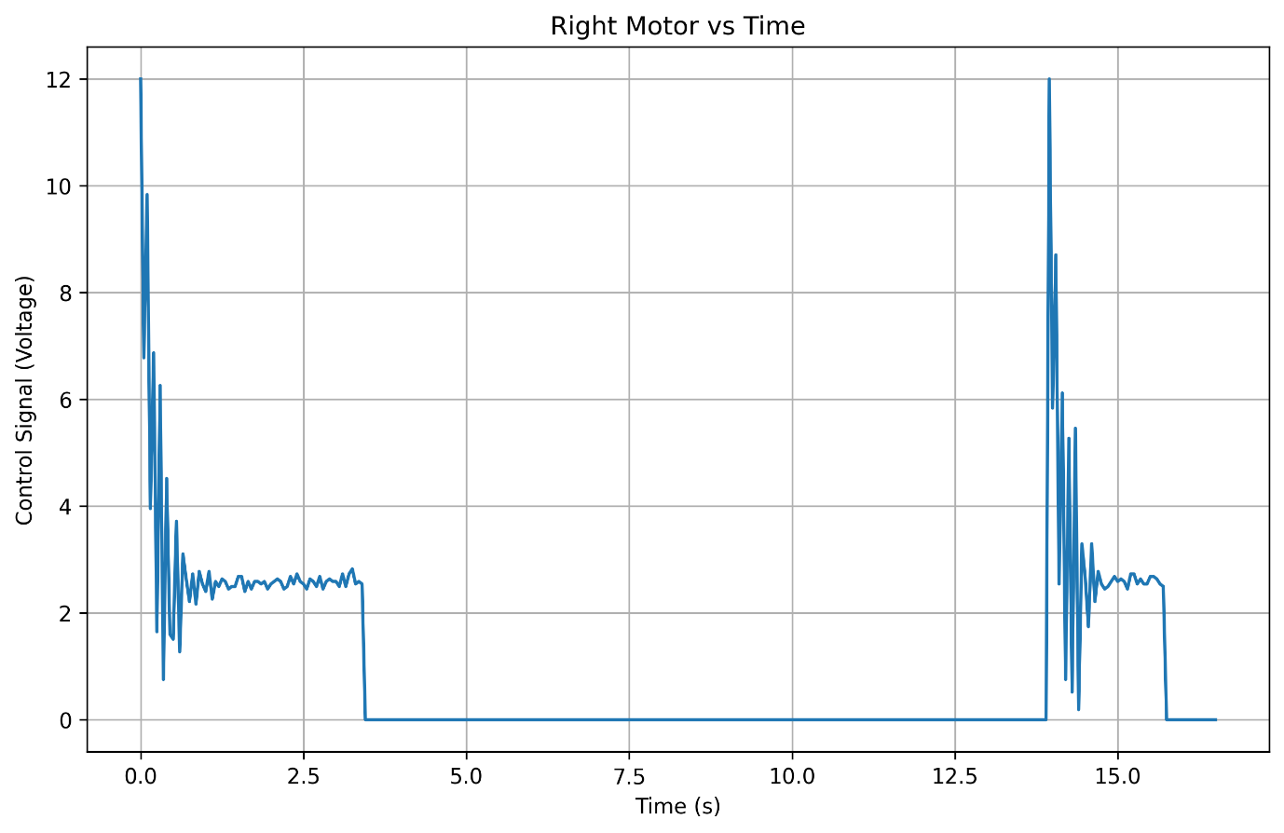
[picture p46: figure]

⁵0

شکک :26-4 نمودار سیگنالهای کنترلی اعمال شده به موتور راست ربات در مسیر با مانع و حرکت از بین موانع
همانطور که مشاهده میشود ربات به خوبی مسیر را طی کرده و در مواجه با موانع ایست کردهاست،
با توجه به عدم وجود مانع در مسیر مستقیم تغییر جهت نداده و با خطایی بسیار جزوی به هدف در نقطه و150,0 رسیده است.

در شکک ،27-4 یک نمونه از تصویر گرفتهشده توسم دوربین و نتیجه پردازش انجام شده بر روی آن
در شکک ،28-4 نابک مشاهده است:

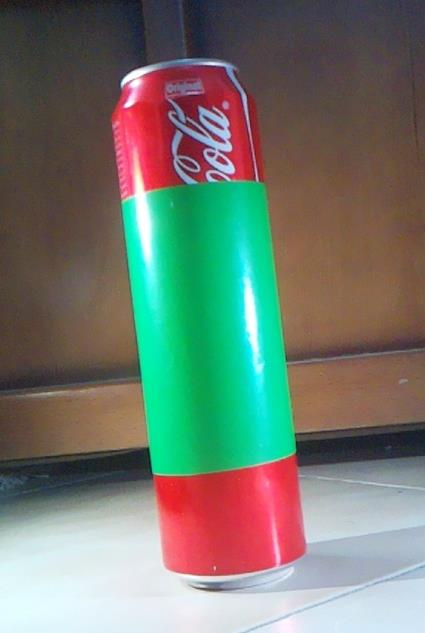
[picture p47: figure]
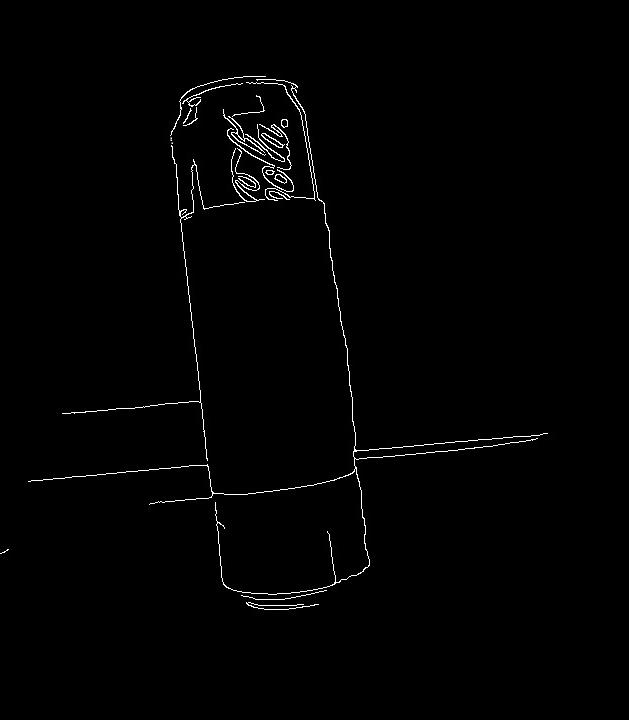
[picture p48: figure]

⁵1

شکک :27-4 یک نمونه از تصاویر گرفتهشده از مانع توسم دوربین

شکک :28-4 تصویر گرفتهشده در شکک 27-4 پس از اعمال الگوریتم پردازش تصویر

⁵2

### 4-4 جمعبندی و پیشنهادات

در این فصک نتایج عملکرد ربات طراحیشده، مورد بررسی نرار گرفت. در ابتدا عملکرد ربات در رسیدن
به هدف در حالتی که هیچ مانعی وجود ندارد ارزیابی شد. در مرحله بعدی، با ورود مانع به جهان ربات، الیه کنترلی باال، توانست با تغییر جهت ربات به صورت حریصانه، آن را از م وانع دور کند و به سمت هدف ببرد. نتایج بدست آمده، توانایی ربات را در حرکت در محیم ناشناخته، نشان میدهد.

در ارتباط با پیشنهادات و مراحک بعدی میتوان به موارد زیر اشاره کرد:

.1 توسعه یک برد الیه پایین و یک برد الیه باال ربات از پایدار مکانیکی و الکتریکی بیشتری برخوردار باشد.
.2 از حسگر لیزری برای فاصلهسنجی استفاده شود تا ربات از دنت باالتری برخوردار شود. .3 از حسگ رهای IMU، در جهت بررسی اطفعات مونعیت یابی استفاده شود و از ترکیب اطفعات با استفاده از روش فیلتر کالمن، کنترل الیه پایین ربات از دنت بیشتری برخوردار باشد.
.4 برای توسعه نرمافزاری راحتتر، از ROS بهره برده شود.

⁵3

## مراجع

[1] Krishna, G., Reddy, T., and Rao, P. (2019). Wall following robot using PID controller. International Journal of Engineering Research & Technology, 8(5), 102-106.
[2] LaValle and S. M. (2001). Rapidly-exploring random trees: A new tool for path planning. IEEE Robotics and Automation Magazine, 5(3), 39-42.
[3] Hart, P. E., Nilsson, N. J., & Raphael, B. (1968). A formal basis for the heuristic determination of minimum cost paths. IEEE Transactions on Systems Science and Cybernetics, 4(2), 100-107.
[4] Cadena, C., Carlone, L., Carrillo, H., Latif, Y., Scaramuzza, D., Neira, J., ... & Leonard, J.
J. (2016). Past, present, and future of simultaneous localization and mapping: Towards the robust-perception age. IEEE Transactions on Robotics, 32(6), 1309-1332.
[5] Khatib, O. (1986). Real-time obstacle avoidance for manipulators and mobile robots. The International Journal of Robotics Research, 5(1), 90-98.
[6] E. Baek, Y. Ho, “Depth Estimation and View Synthesis using Vanishing Point from Single View Image.” in Proceedings of ICESIT Conference, 2014.
[7] “An Object Distance Measuring Method of Monocular Vision Mobile Robot,” International Journal of Control and Automation, vol. 11, no. 3, pp.117-128, 2018.
[8] S. Diamantas, S. Astaras and A. Pnevmatikakis, “Depth estimation in still images and videos using a motionless monocular camera,” in Proceedings of IEEE International Conference on Imaging Systems and Techniques (IST), Chania, 2016.
[9] I. Susnea, V. Minzu, G. Vasiliu, “Simple, Real-Time Obstacle Avoidance Algorithm for Mobile Robots,” in Proceedings of the 8th WSEAS International Conference on Computational Intelligence, Man-Machine Systems and Cybernetics, Puerto de la Cruz, Spain, 2009.
