Arshiagosh/Vision-Obstacle-Avoidance-Robot/docs/figures/goal_100_0.png

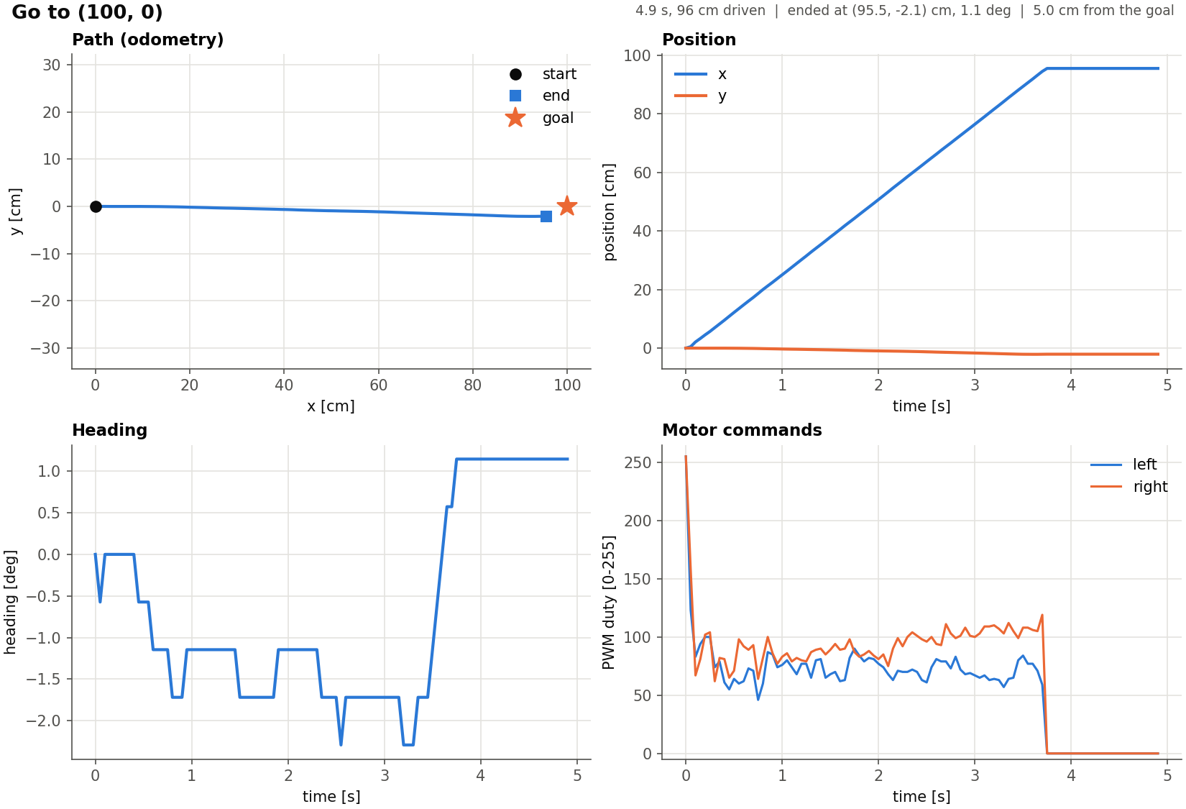
docs/figures/goal_100_0.png
