Arshiagosh/Vision-Obstacle-Avoidance-Robot/docs/figures/goal_100_-50.png

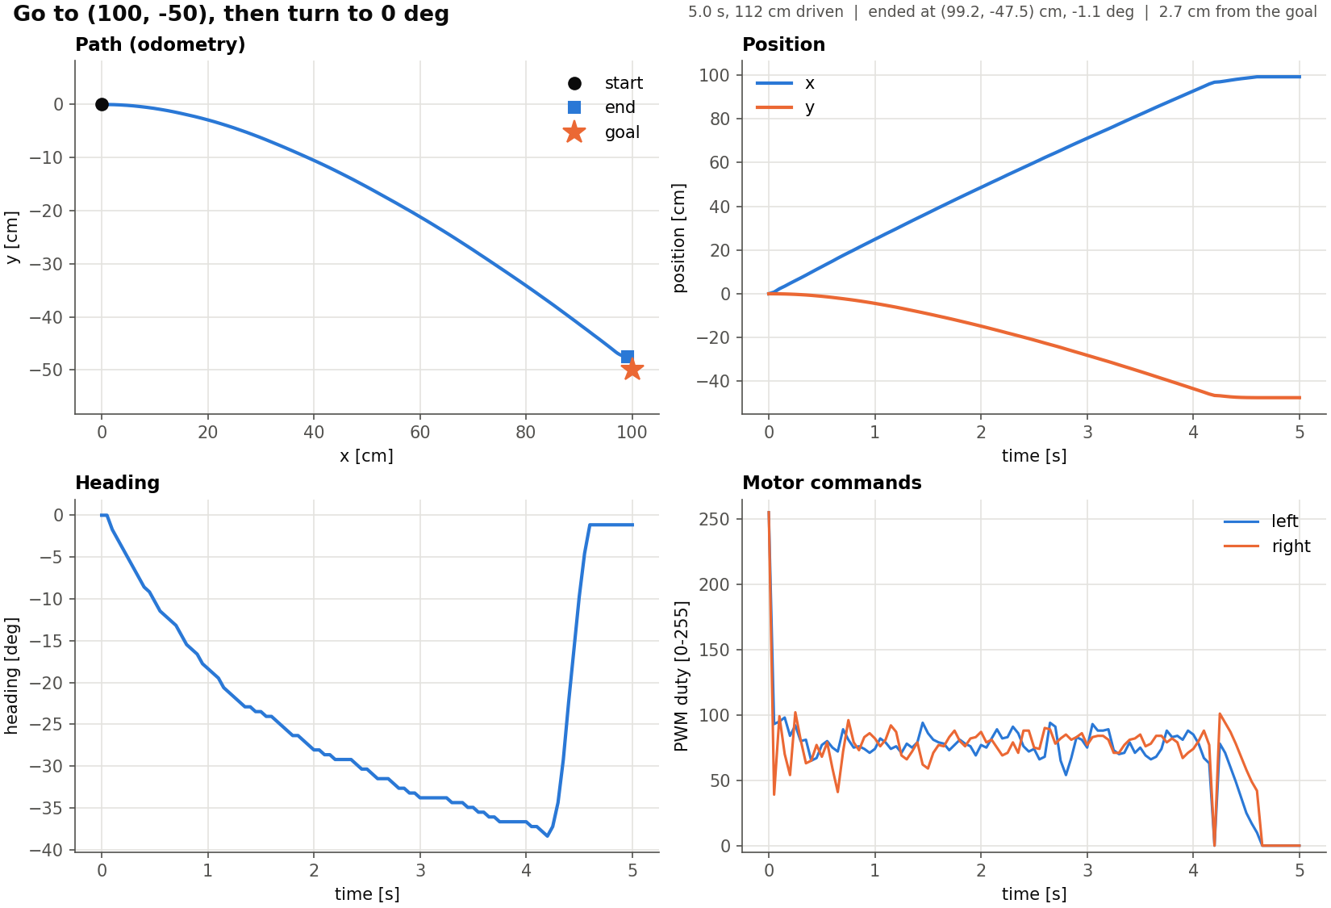
docs/figures/goal_100_-50.png
