Arshiagosh/Vision-Obstacle-Avoidance-Robot/raspberry_pi/calibration/reference.png

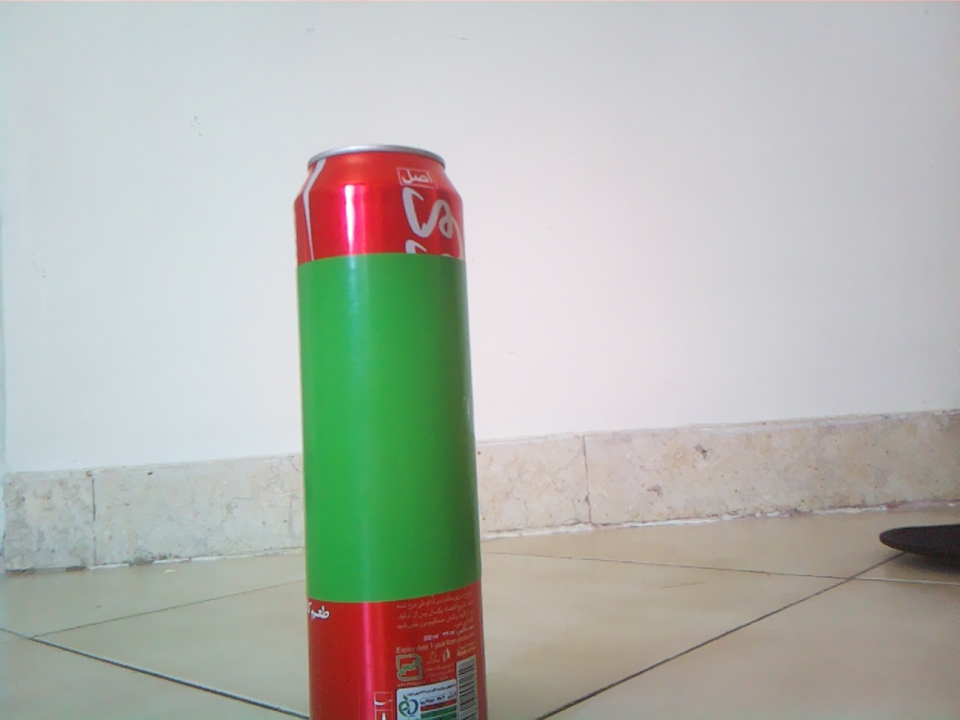
raspberry_pi/calibration/reference.png
