Arshiagosh/Vision-Obstacle-Avoidance-Robot/(commit log)

2026-10-07 🎉 Initial commit
2026-10-07 🚚 Brought over the original code from the robot.
    Straight copy of what was running on the Arduino and the Pi back in
    Shahrivar 1403, before any cleanup:
    - firmware/: the go-to-goal sketch running on the Uno
    - raspberry_pi/: the high-level side (sensors, camera, serial, avoidance)
    with all three mains I was juggling during the tests
    Not pretty, but I want the history to start from what actually ran.
    [GotoXYPHI_UART.ino, main.py]
2026-10-07 📊 Added the odometry logs from the test runs.
    Renamed the clean runs after their goals and moved the messy tuning
    sessions into data/logs/tuning. Dropped the two (0, 100) logs since they
    were all zeros. The README explains the log format.
2026-10-07 ♻️ Rewrote the Arduino sketch so it's actually readable.
    Same controller, same gains, same telemetry format, just organized:
    - A small IDLE / GOTO / ROTATE state machine instead of the flagStop 0/1/2
    magic numbers.
    - Each wheel is a struct (pins, PID, encoder count, speed, pwm) instead of
    passing seven references around and checking `in1 == IN1` to figure out
    which motor it is.
    - Serial commands are read without readStringUntil(), which could block the
    control loop for up to a second on a half-received line.
    - Telemetry is printed field by field instead of gluing Strings together
    (heap fragmentation on the Uno).
    One real behaviour change: ROTATE now works anywhere. Before, it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
2026-10-08 🐛 Camera distance actually returns a distance now.
    calculate_distance_from_object() was returning the frame instead of the
    distance, so main.py ended up comparing a whole image with 20 cm. mainV2
    and mainV3 worked around it by doing the math inline in a commented-out
    block.
    - returns the distance in cm, or None if there's no green object
    - focal_length_finder() really computes F from the reference image now,
    the 915.555 we ran with lives in constants.py as FOCAL_LENGTH
    - is_green() uses the HSV limits from constants.py instead of its own copy
2026-10-08 🐛 Ultrasonic reads can't hang the program anymore.
    measure_distance() busy-waited on the echo pin with no way out, so one
    missed echo (soft obstacle, bad angle, loose wire) froze everything. It
    now gives up after 30 ms and returns None, and the callers treat None as
    "nothing there".
    Also calling setup_ultrasonic() from __init__ — mainV2 never called it.
2026-10-08 🐛 Clip every scan reading to the bubble range.
    find_avoid() only replaced None with 20 cm, but mainV2 kept readings up to
    30 cm. So something at 25 cm got *more* weight than empty space, and the
    robot could turn towards it. Now everything is clipped to the same range.
    It also ignored the theta_sensors argument, and returned 0 (= hard right)
    when every reading was zero. 90 (straight ahead) makes more sense there.
2026-10-08 ♻️ Reorganized the Pi code and merged the three mains into one.
    main.py, mainV2.py and mainV3.py were three snapshots of the same idea
    (the last one even had the test sequence hardcoded). Now there's one main
    with a small CLI:
    python3 main.py 200 0 # go to (200, 0) and avoid obstacles
    python3 main.py 100 -50 --phi 90
    python3 main.py 100 0 --no-avoid # plain go-to-goal
    and the rest lives in a robot/ package:
    - config.py: every pin, gain and threshold in one place
    - serial_link.py: commands, a reader thread that keeps the latest pose,
    queues the "...Reached." messages and writes the log (same format as
    the old logs, but with milliseconds)
    - avoidance.py: b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
    [avoidance.py, config.py, main.py, serial_link.py, servo.py, ultrasonic.py]
2026-10-08 🧪 Added tests for the parts that don't need the robot.
    - avoidance math (rebound angle, clipping, heading wrap, detour point)
    - serial link against a fake port: parsing, logging, event handling
    - the main loop with fake sensors/camera/Arduino, checking the exact
    command sequence of a detour
    - obstacle detection on the real reference image
    Run with `pytest` from the repo root.
2026-10-08 📈 Added a script to plot any run from its log.
    analysis/plot_run.py turns a log into one figure: the path, x/y over time,
    heading and the PWM going to each motor. runlog.py does the parsing and
    handles both the old logs (whole seconds) and the new ones (milliseconds).
    Regenerated the figures for the three clean runs into docs/figures and
    added requirements-dev.txt for running all this on a laptop.
2026-10-09 🖼️ Added photos of the robot, the report figures and the test videos.
    - docs/images: front/top photos, a camera frame before and after the
    detection, and the stop -> turn -> go sequence from the report
    - docs/figures/report: the path plots of all five test runs from the
    thesis (two of them don't have logs anymore, so these are the only
    record)
    - media: two GIFs for the README and the four test videos re-encoded to
    480p so the repo doesn't weigh 17 MB
2026-10-09 📝 Wrote the docs: hardware, how it works and the serial protocol.
    - hardware.md: parts, wiring tables for the Uno and the Pi, photos
    - how_it_works.md: the two control layers, odometry, the PID gains,
    bubble rebound and the camera distance estimate, with the math
    - serial_protocol.md: every command and reply between the Pi and the Uno
    Also fixed the video links in data/README.md now that the videos are in.
2026-10-09 📄 Added the thesis (Persian).
    The final version of the report, as submitted in Shahrivar 1403.
2026-10-09 📝 Wrote a proper README.
    Landing page with the demo GIFs, how the two layers work together, the
    results of all five runs, the hardware at a glance, how to run it on the
    robot and on a laptop, and what I'd improve next. Also added a
    CITATION.cff so GitHub shows the "Cite this repository" button.
2026-10-09 📝 Fixed a few things that looked off on GitHub.
    - Switched the math in how_it_works.md to the $`...`$ and ```math syntax.
    Plain $...$ can clash with Markdown (underscores turning into italics),
    and these are the forms GitHub recommends for that.
    - Gave the hardware table in the README a real header row.
2026-10-09 🐛 GitHub doesn't allow \operatorname in math, use \text for atan2.
